michz/diy14bus/ideas.md

Brainstorming, Ideas
====================

pseudo ACK mechanism
--------------------
When packet is broadcasted to network, we can check if it was received by
waiting for receiving the same packet relayed by another node.
