michz/diy14bus/first-test-cowbus-one/README.md

first-test
==========

Simple LED blinking test for cowbus-one-board
