michz/diy14bus/spi-test-f0/README.md

first-test
==========

Simple LED blinking test for STM32F3Discovery
