michz/diy14bus/boards/cowbus-protoboard/pdf/schematics/cowbus-protoboard.pdf

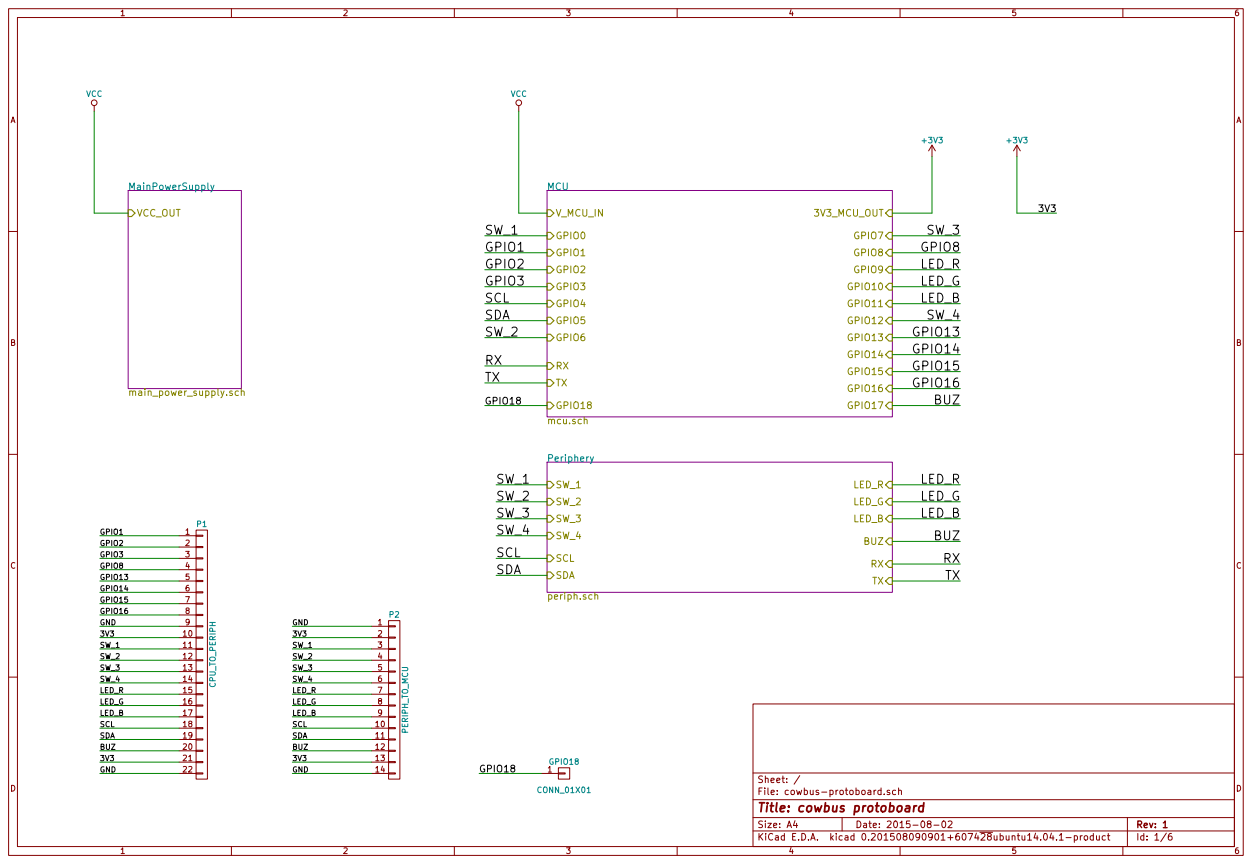
[picture p1: page 1]

File: cowbus-protoboard.sch Sheet: /
Id: 1/6 Title: cowbus protoboard

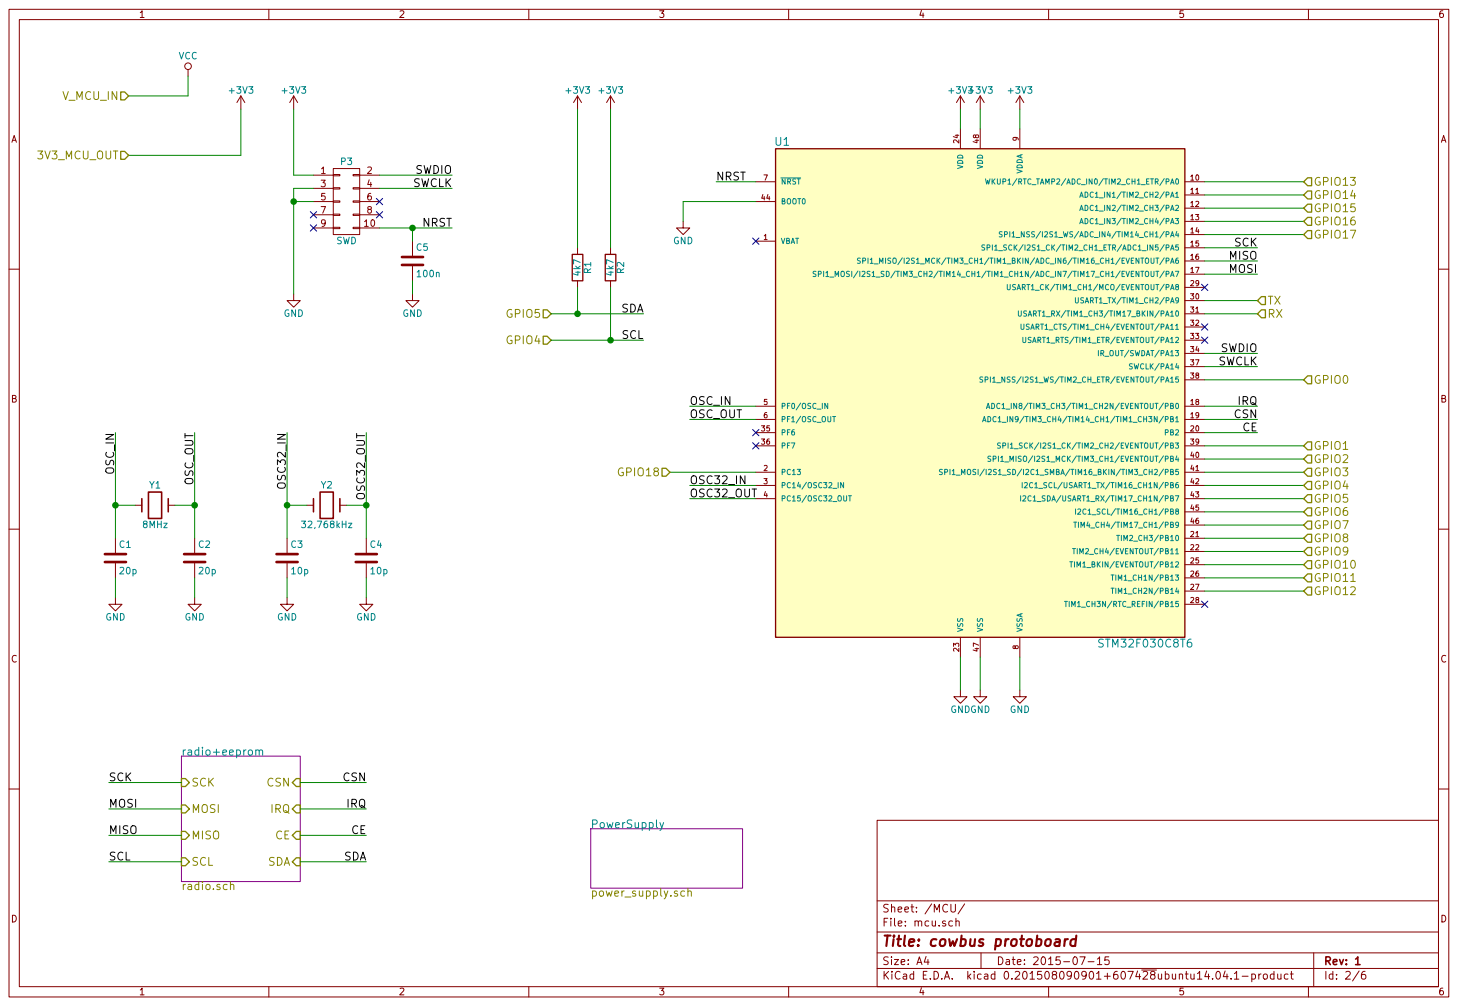
[picture p2: page 2]

File: mcu.sch Sheet: /MCU/
Id: 2/6 Title: cowbus protoboard

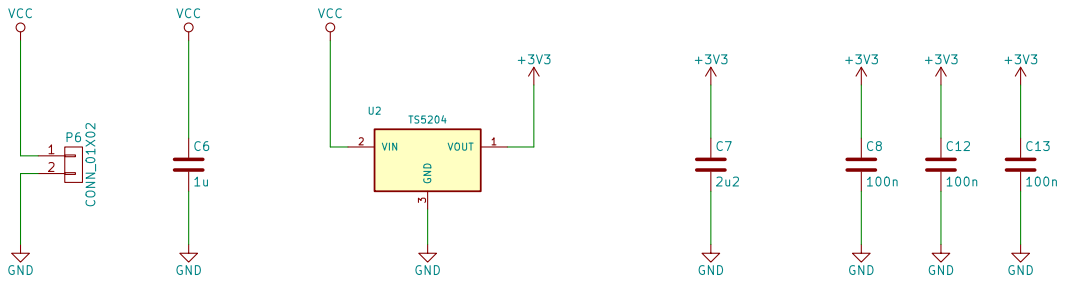
[picture p3: page 3]

File: power_supply.sch
Id: 3/6 Title: cowbus protoboard

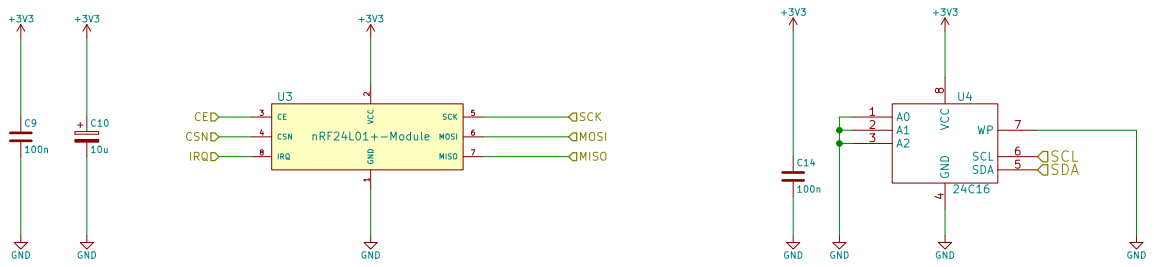
[picture p4: page 4]

2 CE 3 CSN 4 SCK 5 MOSI 6 MISO 7

File: radio.sch Sheet: /MCU/radio+eeprom/ GND

Id: 4/6 Title: cowbus protoboard

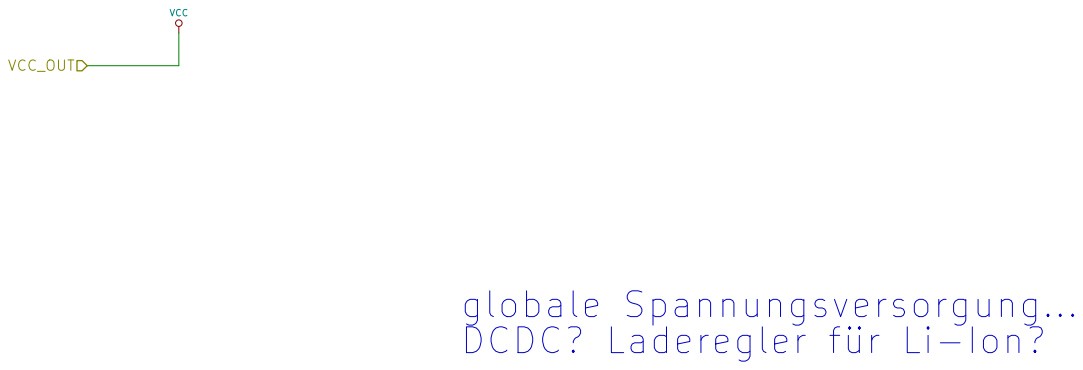
[picture p5: page 5]

globale Spannungsversorgung...
DCDC? Laderegler für Li-Ion?

Sheet: /MainPowerSupply/
File: main_power_supply.sch
Id: 5/6 Title: cowbus protoboard

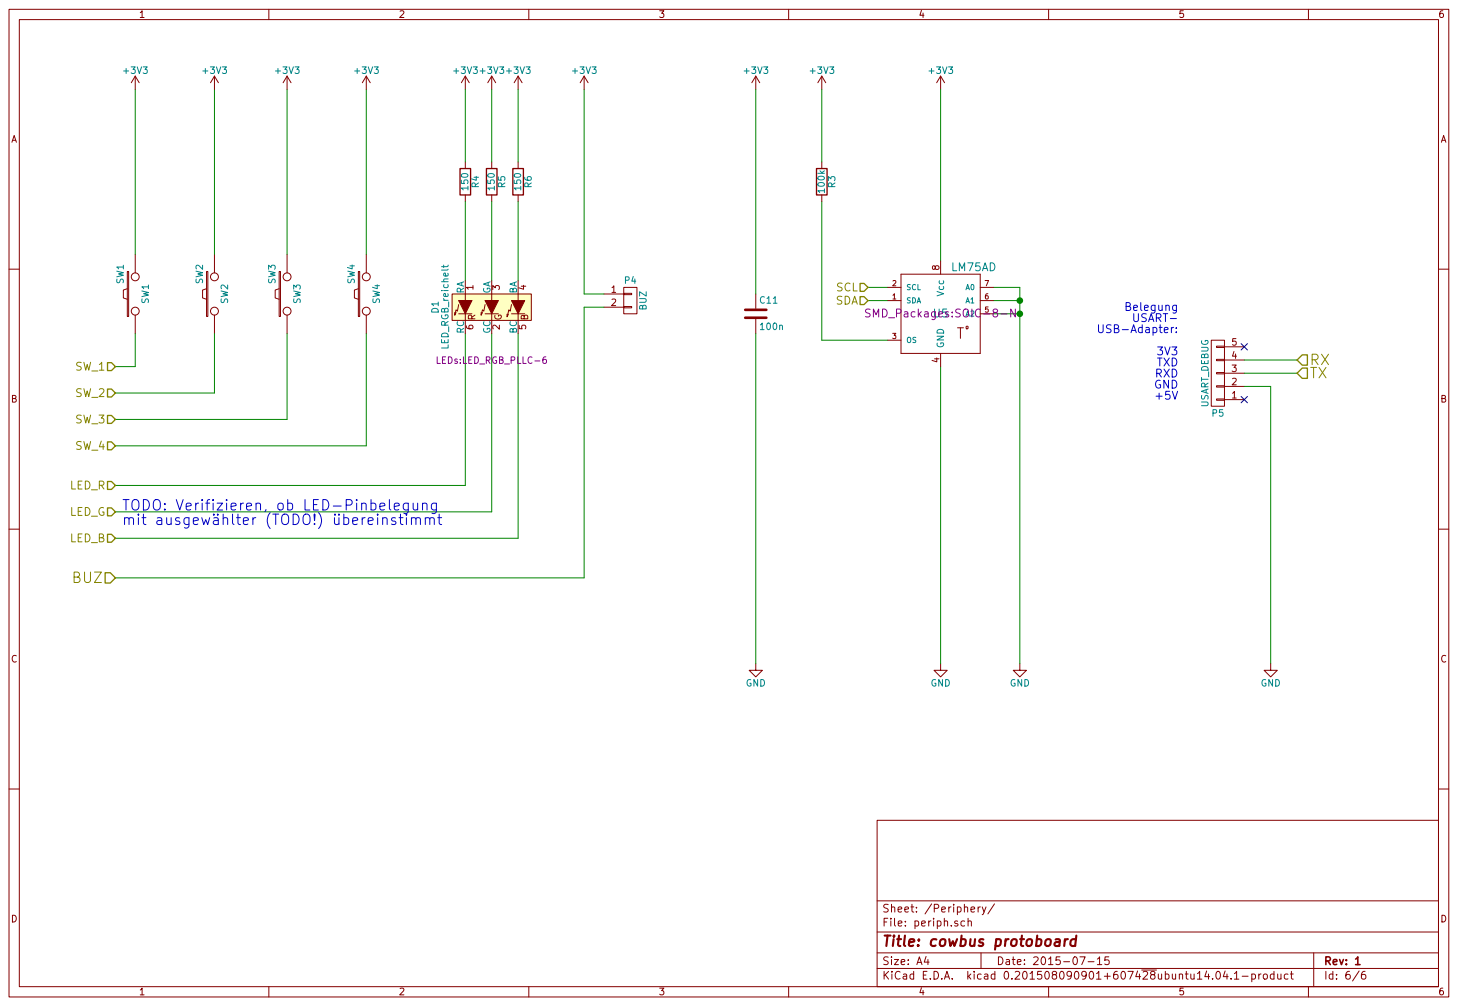
[picture p6: page 6]

TODO: Verifizieren, ob LED-Pinbelegung

File: periph.sch
Id: 6/6 Title: cowbus protoboard
