michz/diy14bus/boards/d14b_button/d14b_button.pdf

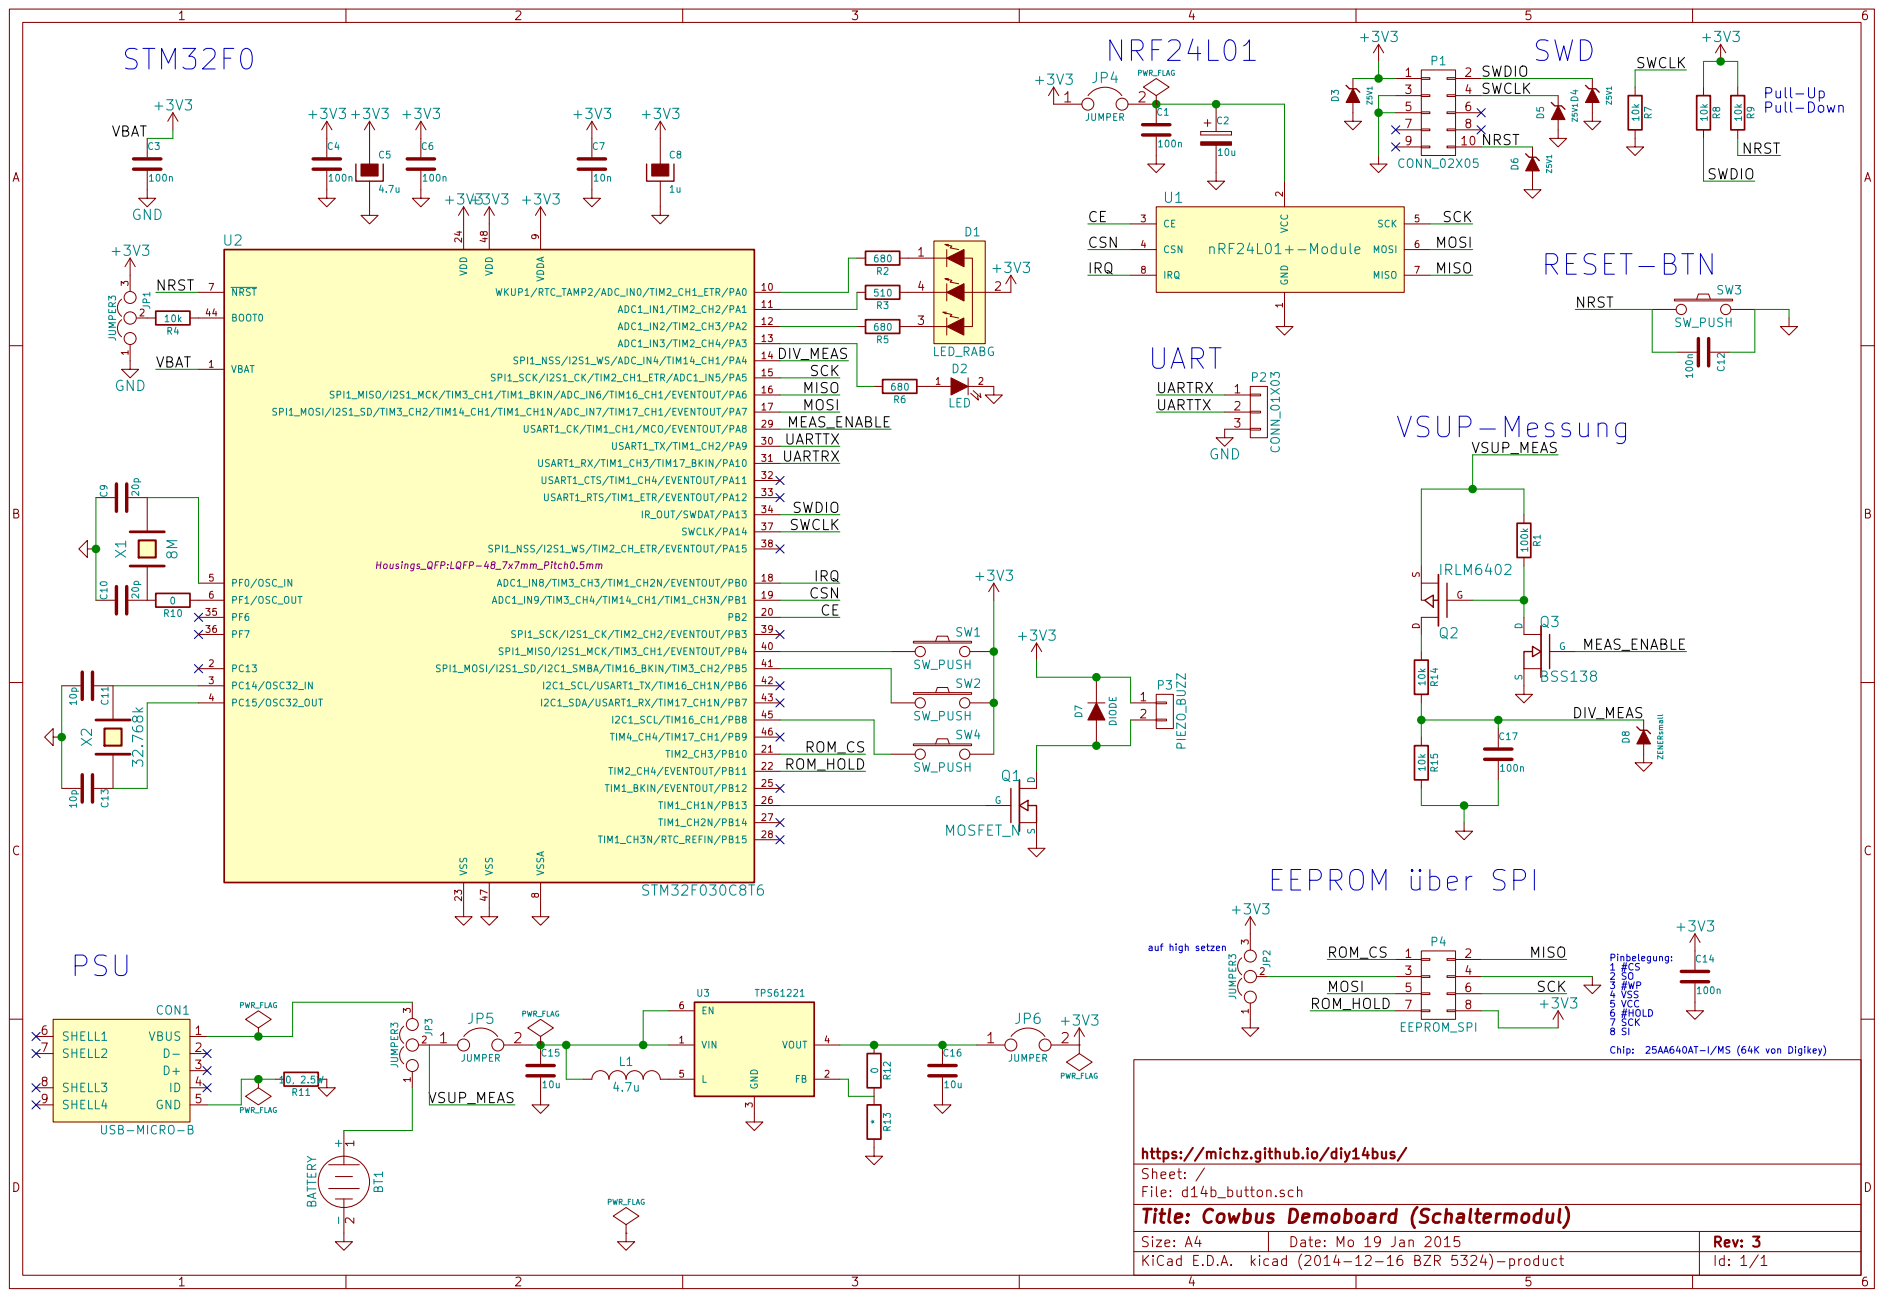
[picture p7: page 1]

File: d14b_button.sch Sheet: / https://michz.github.io/diy14bus/ GND

2 CE 3 CSN 4 SCK 5 MOSI 6 MISO 7

8 SI Chip: 25AA640AT-I/MS (64K von Digikey) 1

Id: 1/1 Title: Cowbus Demoboard (Schaltermodul)
