michz/diy14bus/boards/cowbus-protoboard/pdf/layout/cowbus-protoboard-F_SilkS.pdf

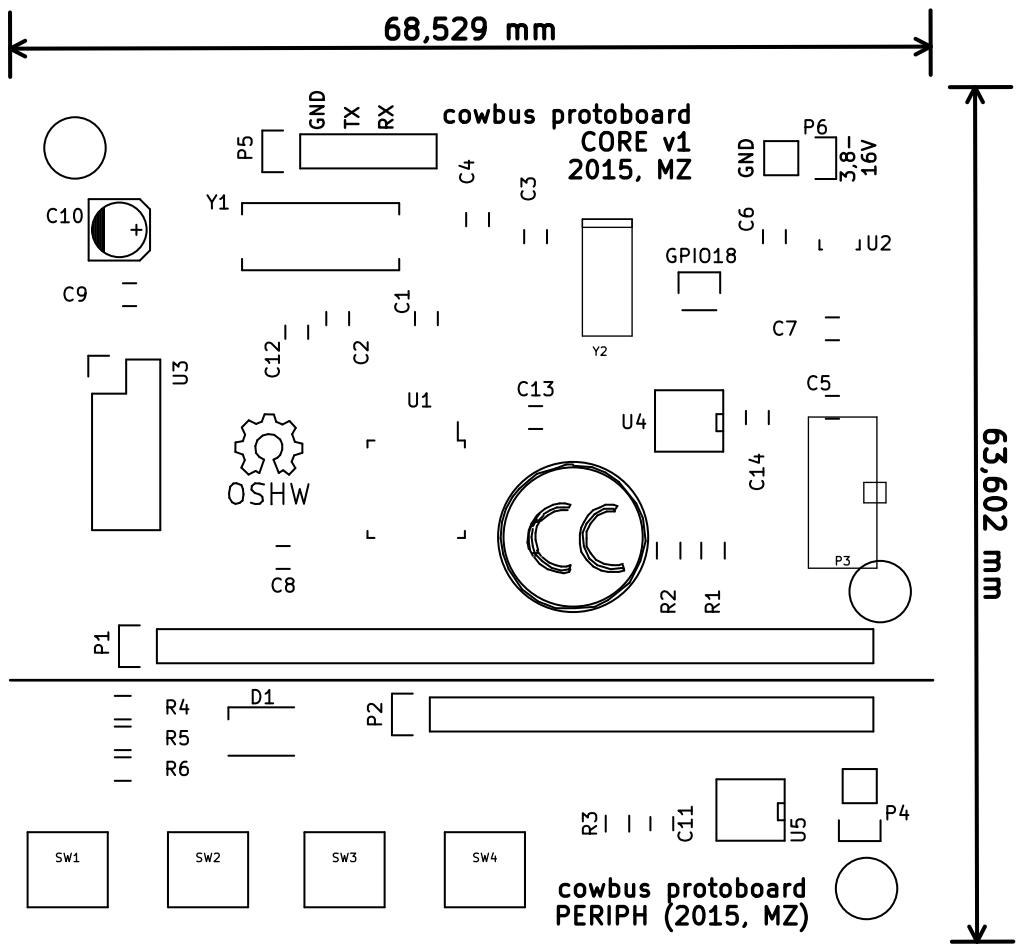
[picture p8: page 1]

GND 3,8- 16V GND TXRX 63,602 mm
