michz/diy14bus/boards/d14b_button/d14b_button-B_Cu.pdf

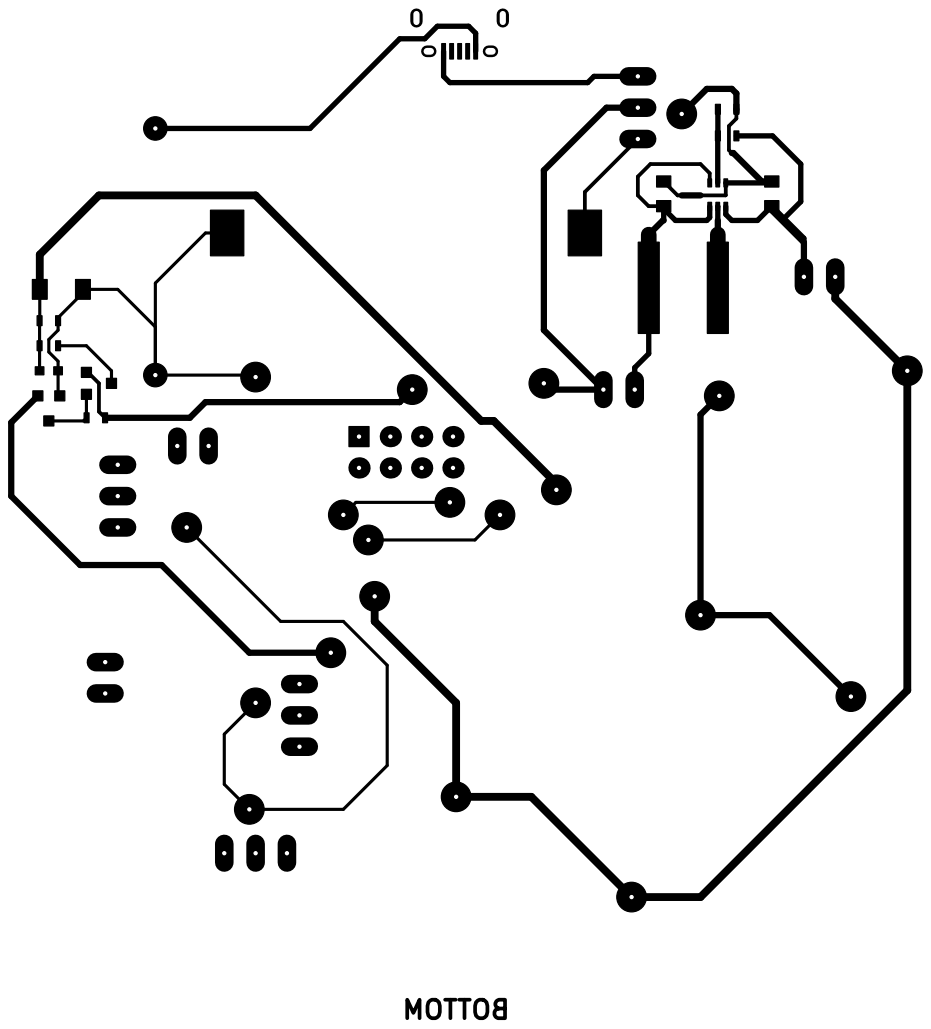
[picture p9: page 1]
