michz/diy14bus/boards/d14b_button/d14b_button-F_Cu.pdf

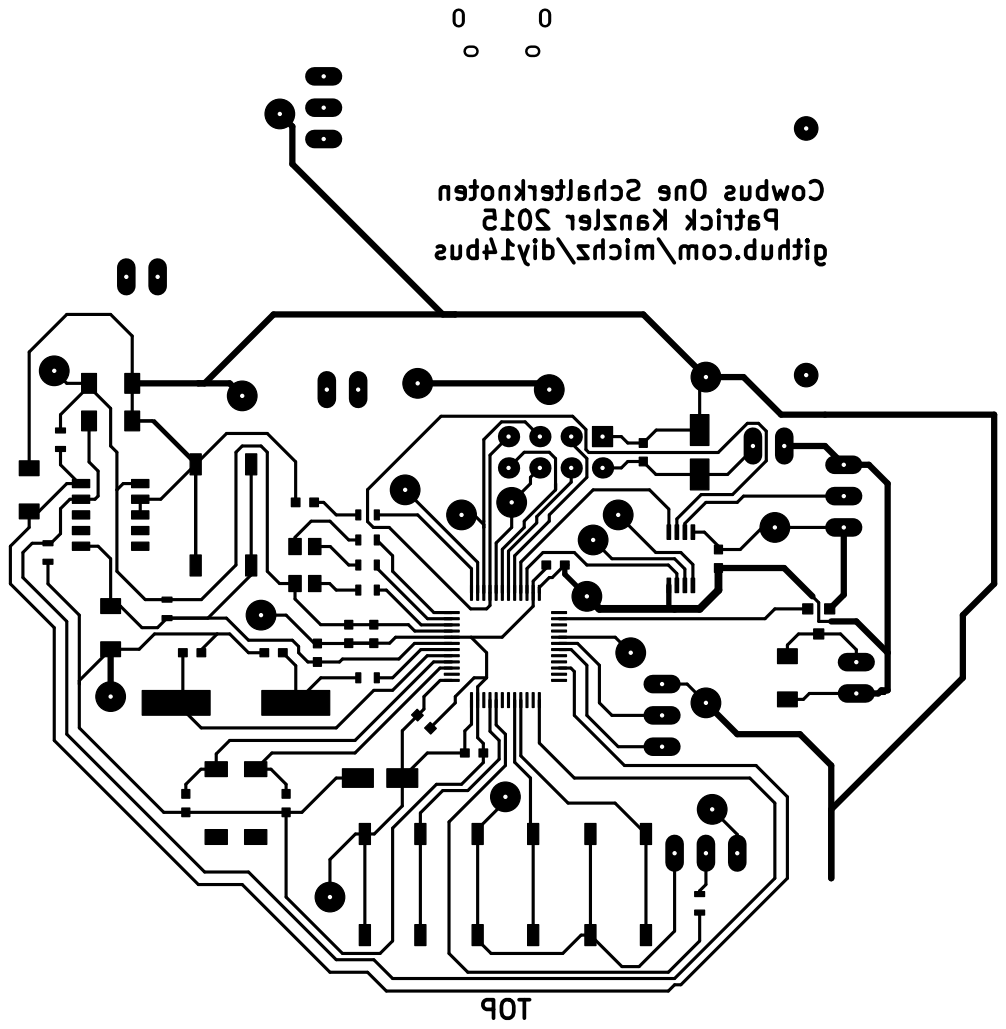
[picture p10: page 1]

Cowbus One Schalterknoten Patrick Kanzler 2015 github.com/michz/diy14bus TOP
