michz/diy14bus/doc/projekt_doku/img/system.pdf

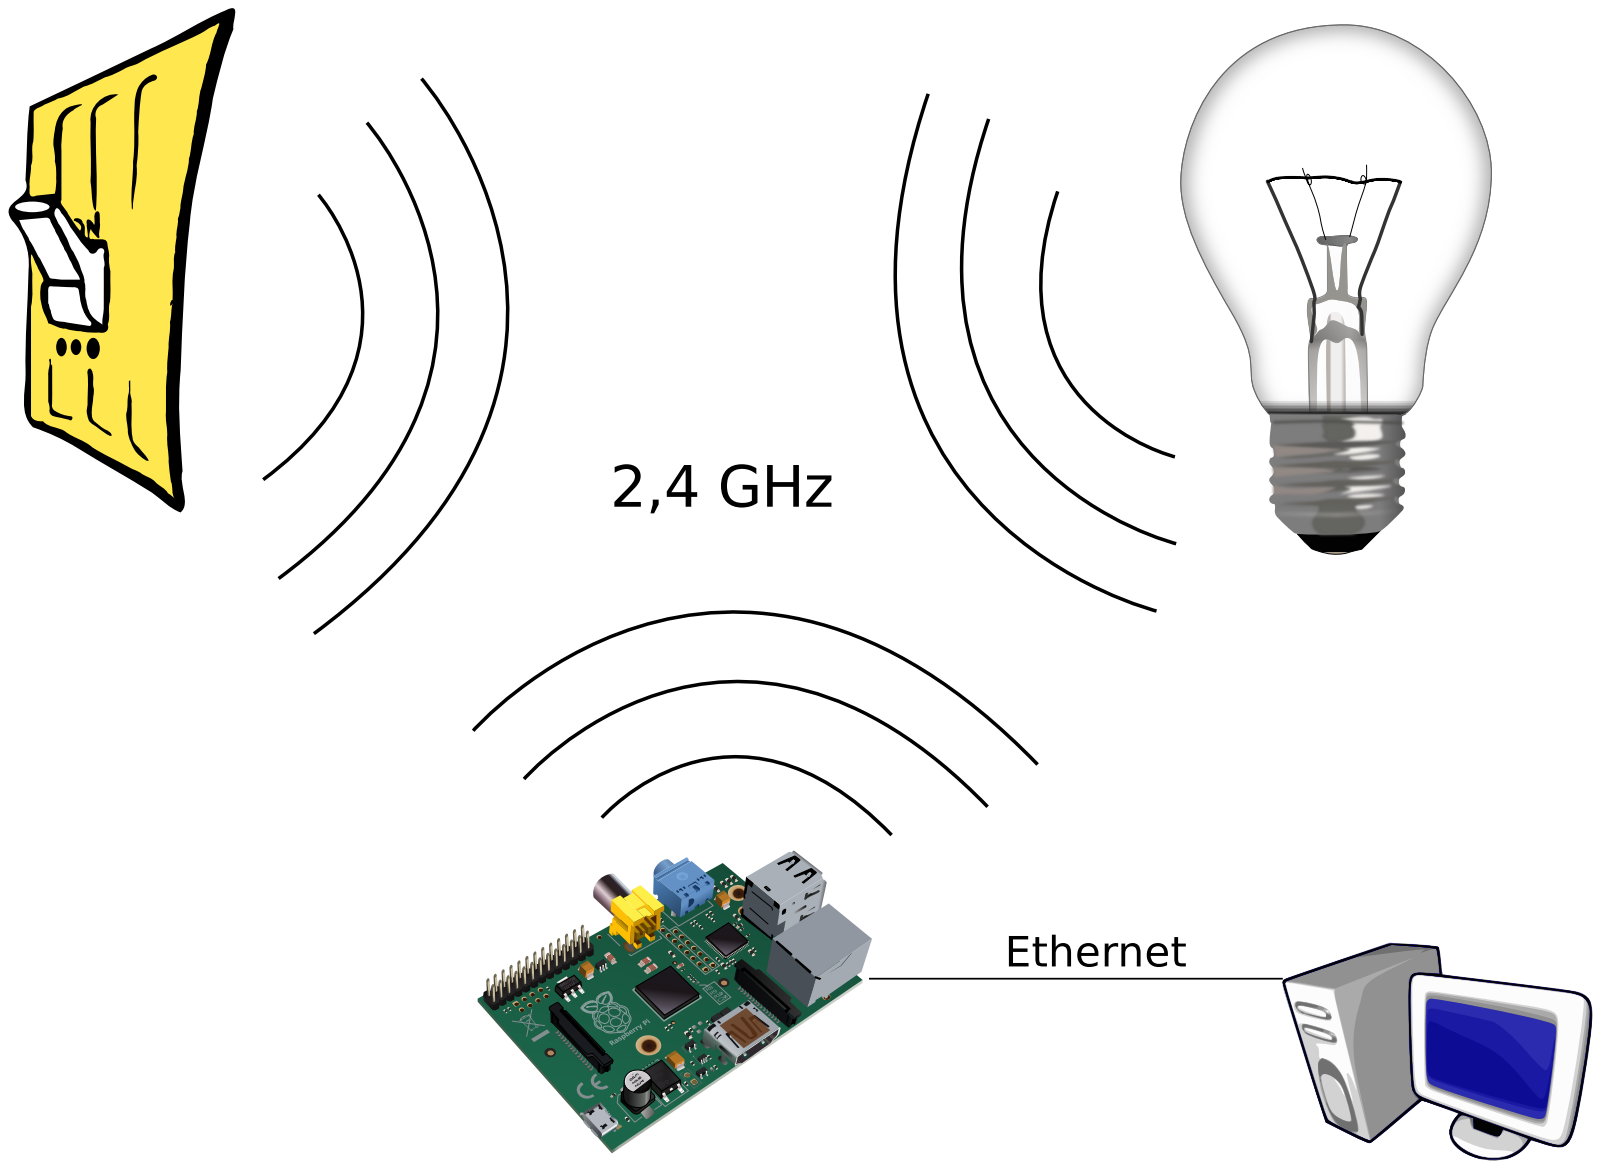
[picture p11: page 1]
