michz/diy14bus/boards/cowbus-protoboard/pdf/layout/cowbus-protoboard-B_Cu.pdf

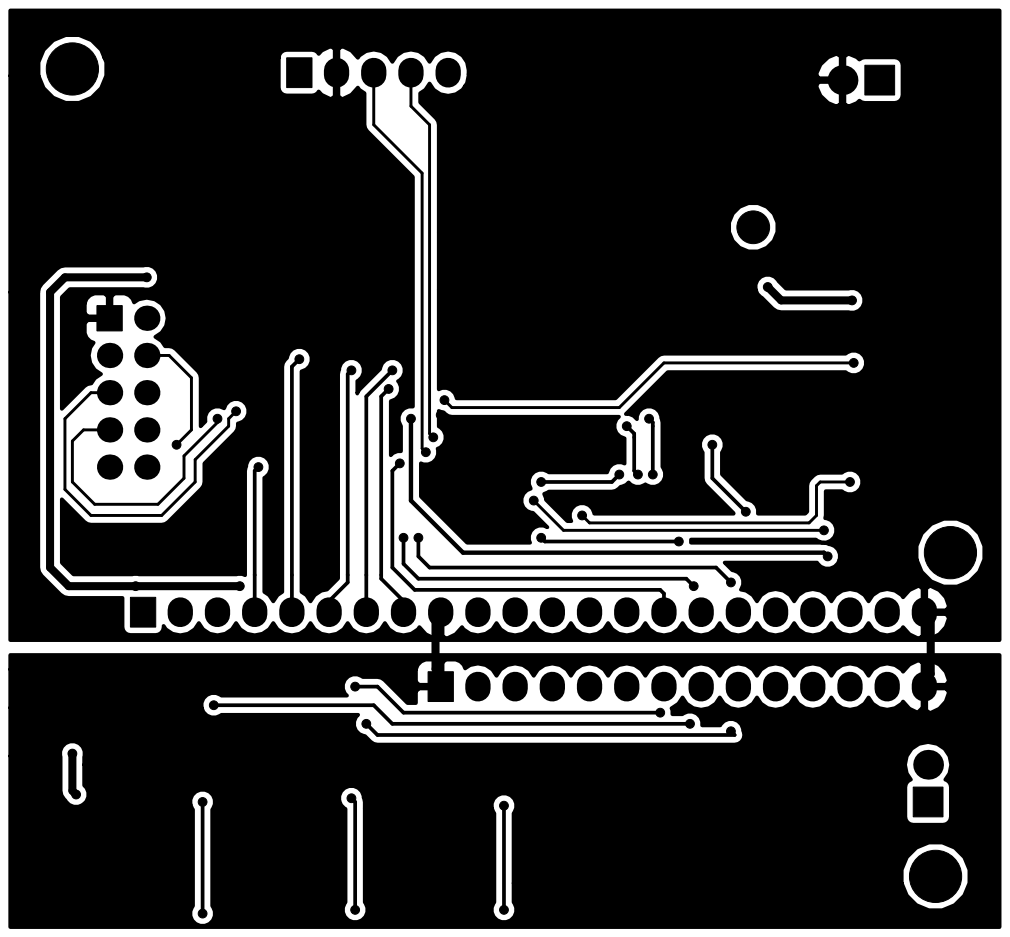
[picture p12: page 1]
