michz/diy14bus/boards/cowbus-protoboard/pdf/layout/cowbus-protoboard-B_Mask.pdf

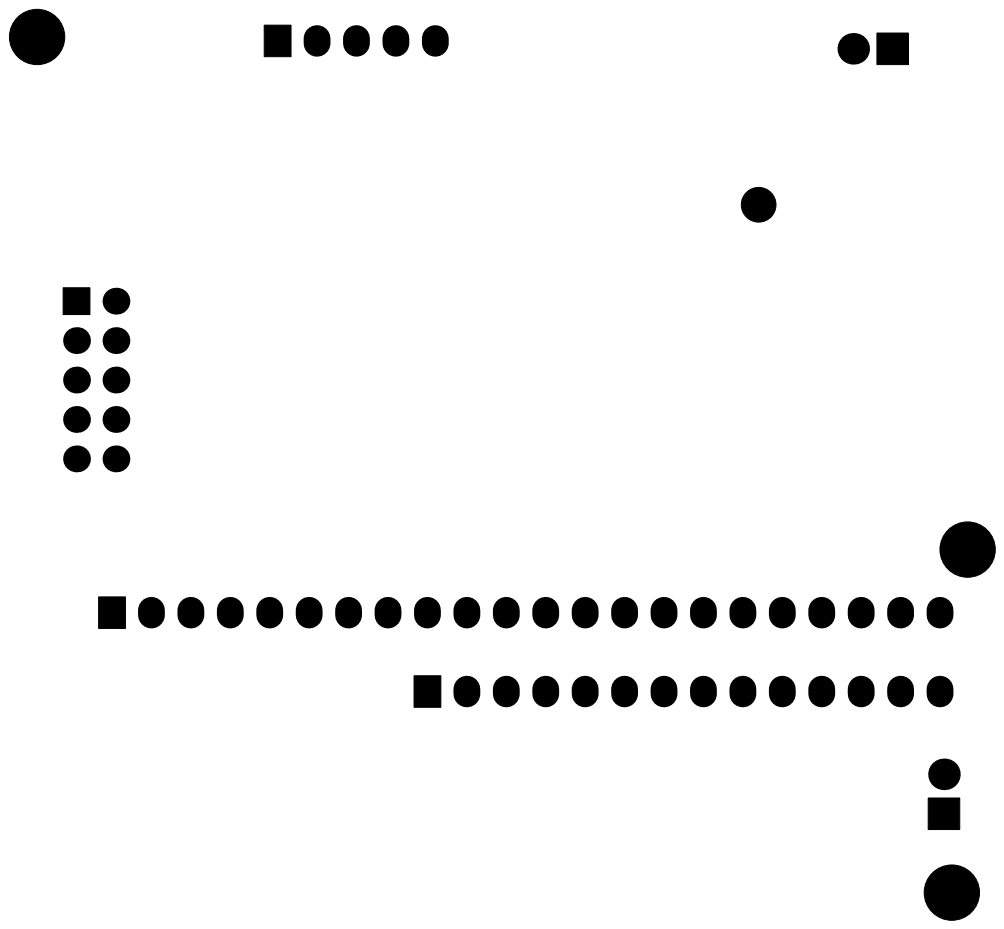
[picture p13: page 1]
