michz/diy14bus/boards/cowbus-protoboard/pdf/layout/cowbus-protoboard-F_Cu.pdf

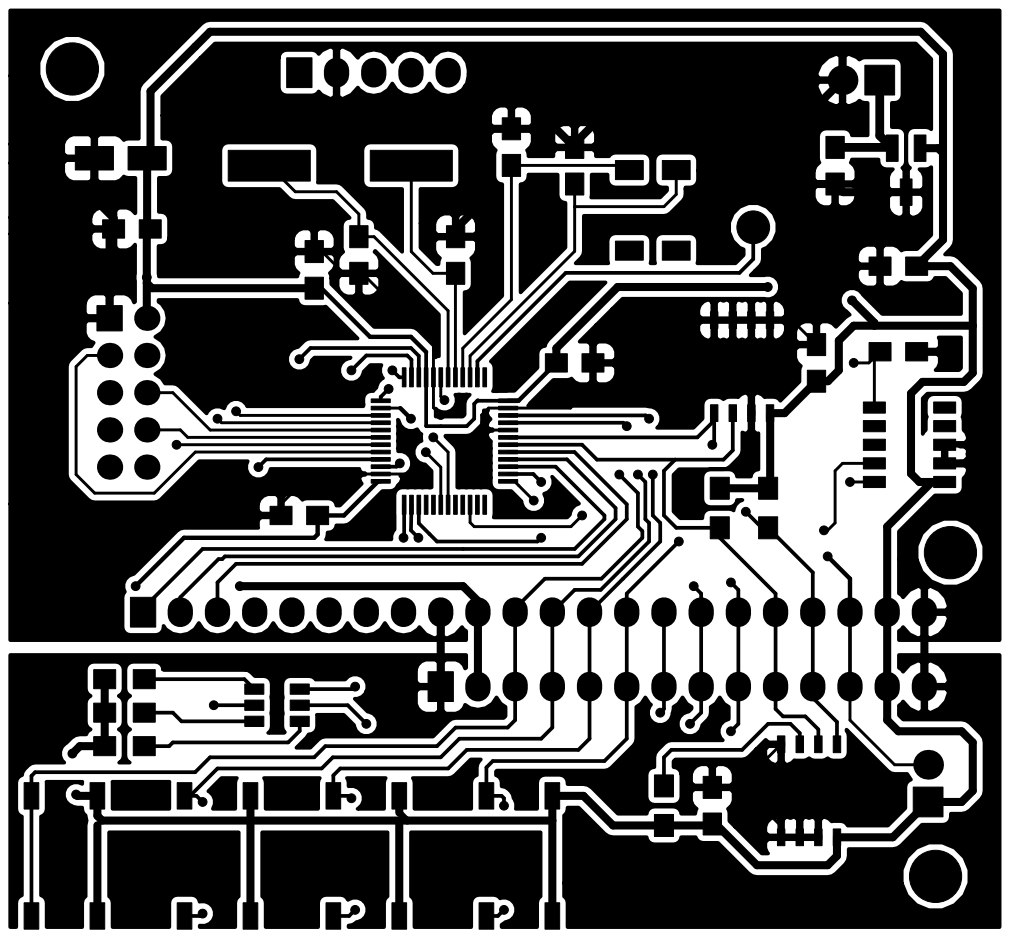
[picture p14: page 1]
