michz/diy14bus/boards/cowbus-protoboard/pdf/layout/cowbus-protoboard-F_Mask.pdf

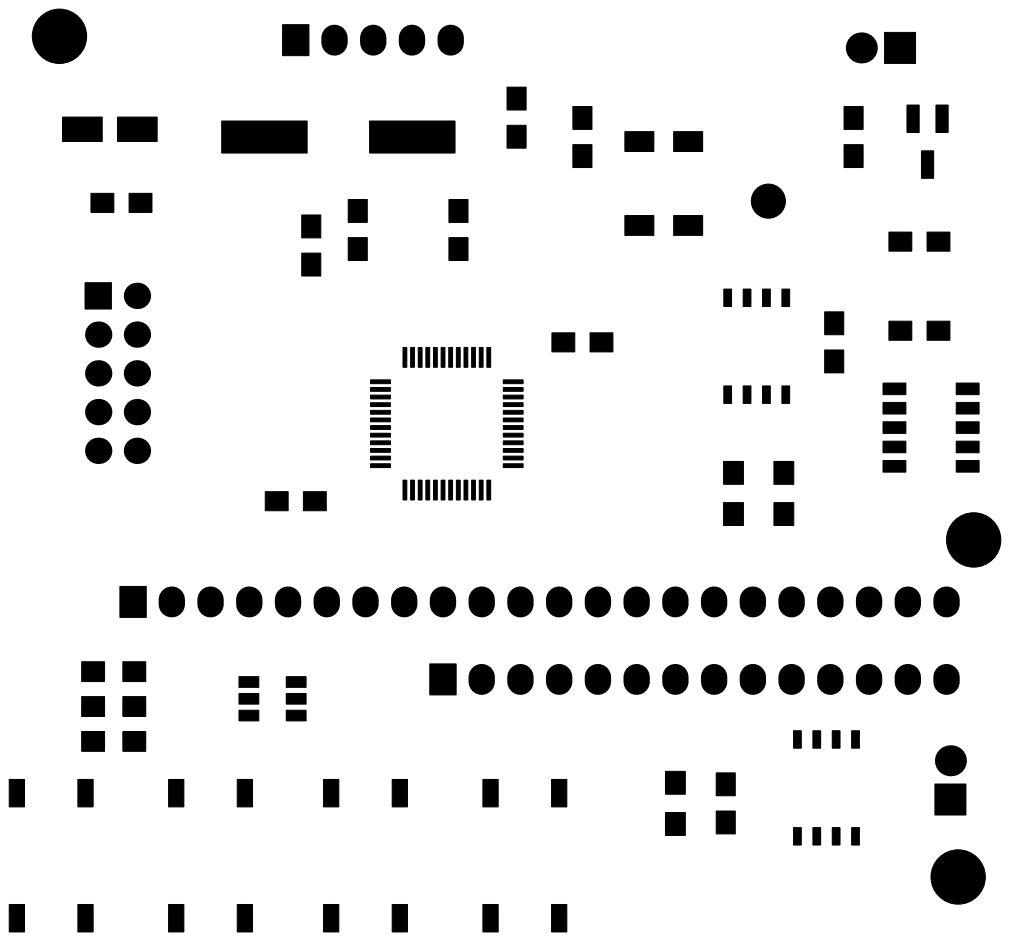
[picture p15: page 1]
