michz/diy14bus/boards/cowbus-protoboard/pdf/layout/cowbus-protoboard-F_Paste.pdf

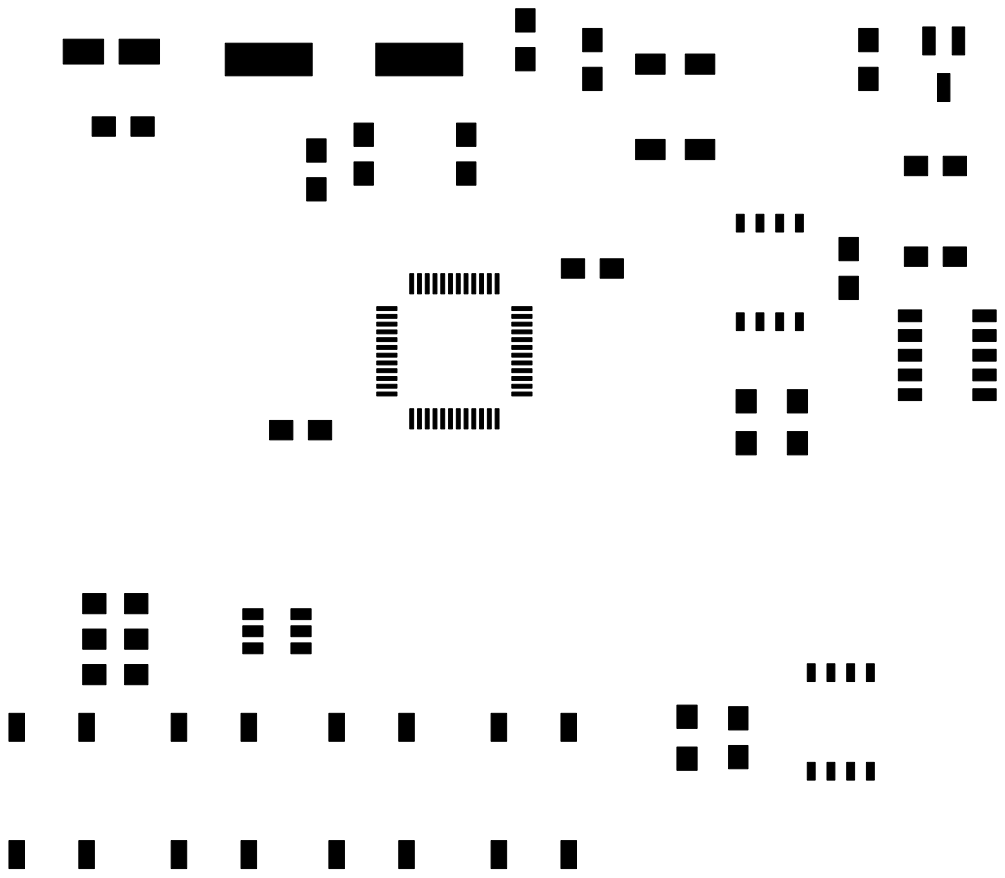
[picture p16: page 1]
