michz/diy14bus/boards/cowbus-protoboard/cowbus-protoboard.kicad_pcb

## KiCad design boards/cowbus-protoboard/cowbus-protoboard.kicad_pcb (2015-08-15)

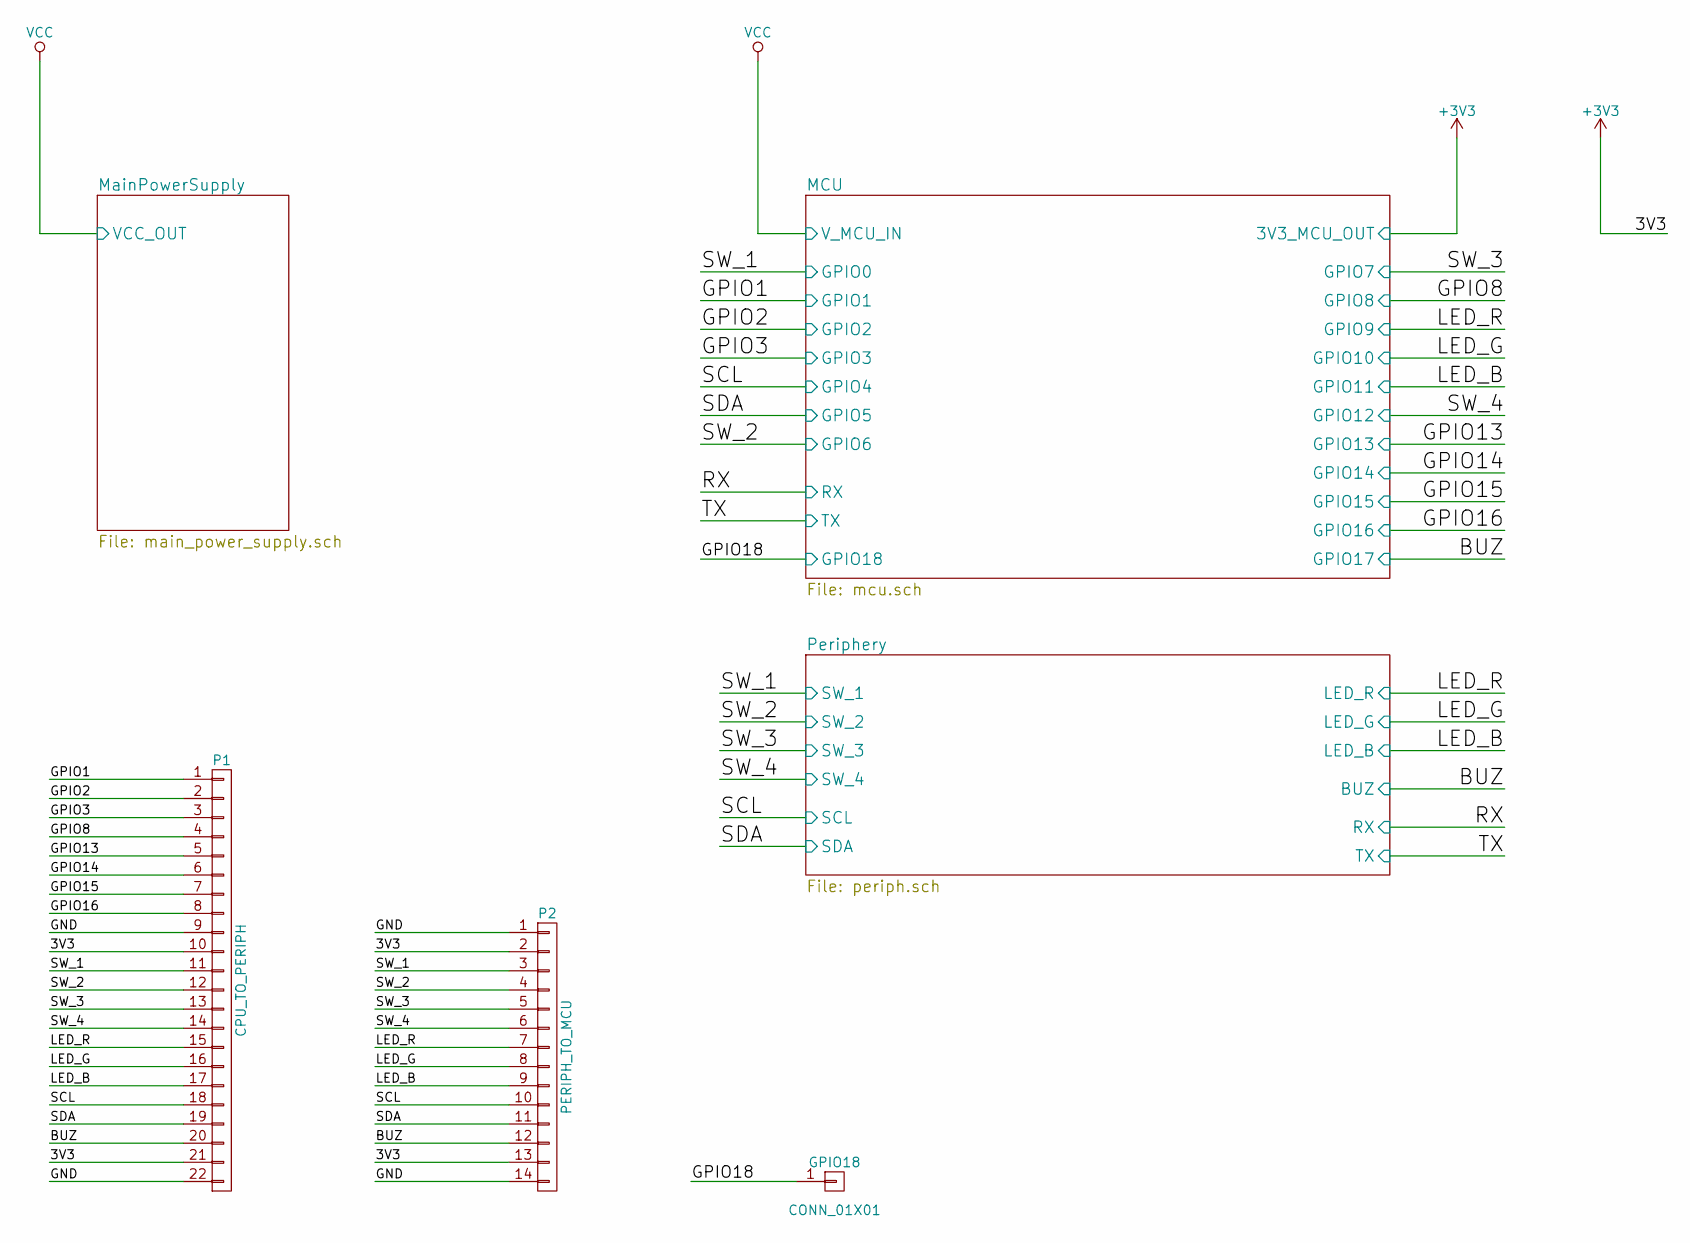
[picture p17: schematic cowbus-protoboard.sch, cowbus protoboard]

Parts:
GPIO18: CONN_01X01; Pin_Header_Straight_1x01
P1: CPU_TO_PERIPH; Pin_Header_Straight_1x22
P2: PERIPH_TO_MCU; Pin_Header_Straight_1x14

Connections:
+3V3: P1.10, P1.21, P2.2, P2.13; also elsewhere on the board
/MCU/GPIO0: P1.11, P2.3; also elsewhere on the board
/MCU/GPIO1: P1.1; also elsewhere on the board
/MCU/GPIO2: P1.2; also elsewhere on the board
/MCU/GPIO3: P1.3; also elsewhere on the board
/MCU/GPIO4: P1.18, P2.10; also elsewhere on the board
/MCU/GPIO5: P1.19, P2.11; also elsewhere on the board
/MCU/GPIO6: P1.12, P2.4; also elsewhere on the board
/MCU/GPIO7: P1.13, P2.5; also elsewhere on the board
/MCU/GPIO8: P1.4; also elsewhere on the board
/MCU/GPIO9: P1.15, P2.7; also elsewhere on the board
/MCU/GPIO10: P1.16, P2.8; also elsewhere on the board
/MCU/GPIO11: P1.17, P2.9; also elsewhere on the board
/MCU/GPIO12: P1.14, P2.6; also elsewhere on the board
/MCU/GPIO13: P1.5; also elsewhere on the board
/MCU/GPIO14: P1.6; also elsewhere on the board
/MCU/GPIO15: P1.7; also elsewhere on the board
/MCU/GPIO16: P1.8; also elsewhere on the board
/MCU/GPIO18: GPIO18.1; also elsewhere on the board
/Periphery/BUZ: P1.20, P2.12; also elsewhere on the board
GND: P1.9, P1.22, P2.1, P2.14; also elsewhere on the board

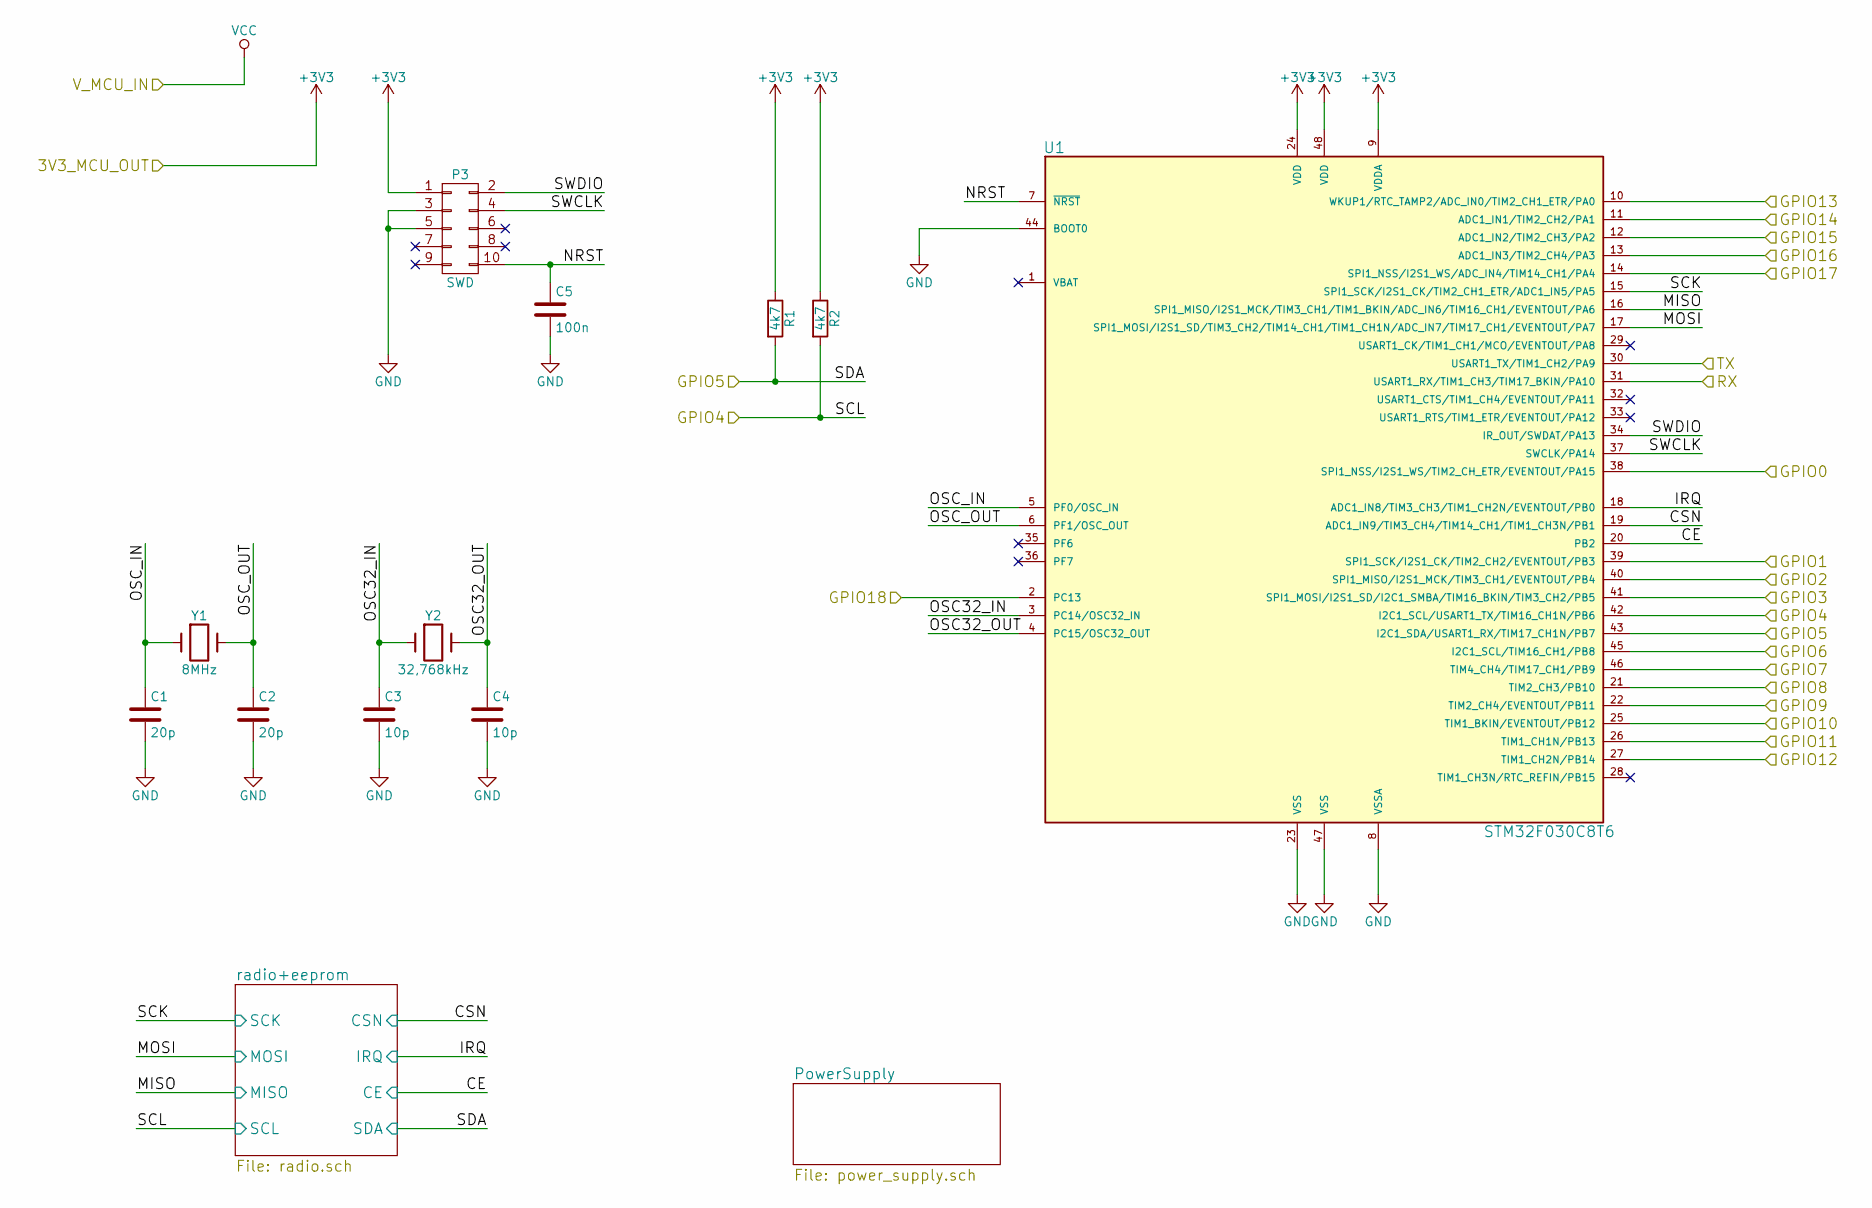
[picture p18: schematic mcu.sch, cowbus protoboard]

Parts:
C1, C2: 20p; C_0805_HandSoldering
C3, C4: 10p; C_0805_HandSoldering
C5: 100n; C_0805_HandSoldering
P3: SWD; CORTEX_header_SMD
R1, R2: 4k7; R_0805_HandSoldering
U1: STM32F030C8T6; LQFP-48_7x7mm_Pitch0.5mm
Y1: 8MHz; Crystal_HC49-SD_SMD
Y2: 32,768kHz; crystal_SMD_CPFB

Connections:
+3V3: P3.1, R1.1, R2.1, U1.9 (VDDA), U1.24 (VDD), U1.48 (VDD); also elsewhere on the board
/MCU/GPIO0: U1.38 (SPI1_NSS/I2S1_WS/TIM2_CH_ETR/EVENTOUT/P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); also elsewhere on the board
/MCU/GPIO1: U1.39 (SPI1_SCK/I2S1_CK/TIM2_CH2/EVENTOUT/PB3); also elsewhere on the board
/MCU/GPIO2: U1.40 (SPI1_MISO/I2S1_MCK/TIM3_CH1/EVENTOUT/PB4); also elsewhere on the board
/MCU/GPIO3: U1.41 (SPI1_MOSI/I2S1_SD/I2C1_SMBA/TIM16_BKIN/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); also elsewhere on the board
/MCU/GPIO4: R2.2, U1.42 (I2C1_SCL/USART1_TX/TIM16_CH1N/PB6); also elsewhere on the board
/MCU/GPIO5: R1.2, U1.43 (I2C1_SDA/USART1_RX/TIM17_CH1N/PB7); also elsewhere on the board
/MCU/GPIO6: U1.45 (I2C1_SCL/TIM16_CH1/PB8); also elsewhere on the board
/MCU/GPIO7: U1.46 (TIM4_CH4/TIM17_CH1/PB9); also elsewhere on the board
/MCU/GPIO8: U1.21 (TIM2_CH3/PB10); also elsewhere on the board
/MCU/GPIO9: U1.22 (TIM2_CH4/EVENTOUT/PB11); also elsewhere on the board
/MCU/GPIO10: U1.25 (TIM1_BKIN/EVENTOUT/PB12); also elsewhere on the board
/MCU/GPIO11: U1.26 (TIM1_CH1N/PB13); also elsewhere on the board
/MCU/GPIO12: U1.27 (TIM1_CH2N/PB14); also elsewhere on the board
/MCU/GPIO13: U1.10 (WKUP1/RTC_TAMP2/ADC_IN0/TIM2_CH1_ETR/PA0); also elsewhere on the board
/MCU/GPIO14: U1.11 (ADC1_IN1/TIM2_CH2/PA1); also elsewhere on the board
/MCU/GPIO15: U1.12 (ADC1_IN2/TIM2_CH3/PA2); also elsewhere on the board
/MCU/GPIO16: U1.13 (ADC1_IN3/TIM2_CH4/PA3); also elsewhere on the board
/MCU/GPIO18: U1.2 (PC13); also elsewhere on the board
/MCU/NRST: C5.1, P3.10, U1.7 (~NRST)
/MCU/OSC32_IN: C3.1, U1.3 (PC14/OSC32_IN), Y2.1
/MCU/OSC32_OUT: C4.1, U1.4 (PC15/OSC32_OUT), Y2.2
/MCU/OSC_IN: C1.1, U1.5 (PF0/OSC_IN), Y1.1
/MCU/OSC_OUT: C2.1, U1.6 (PF1/OSC_OUT), Y1.2
/MCU/RX: U1.31 (USART1_RX/TIM1_CH3/TIM17_BKIN/PA10); also elsewhere on the board
/MCU/SWCLK: P3.4, U1.37 (SWCLK/PA14)
/MCU/SWDIO: P3.2, U1.34 (IR_OUT/SWDAT/PA13)
/MCU/TX: U1.30 (USART1_TX/TIM1_CH2/PA9); also elsewhere on the board
/MCU/radio+eeprom/CE: U1.20 (PB2); also elsewhere on the board
/MCU/radio+eeprom/CSN: U1.19 (ADC1_IN9/TIM3_CH4/TIM14_CH1/TIM1_CH3N/P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); also elsewhere on the board
/MCU/radio+eeprom/IRQ: U1.18 (ADC1_IN8/TIM3_CH3/TIM1_CH2N/EVENTOUT/PB0); also elsewhere on the board
/MCU/radio+eeprom/MISO: U1.16 (SPI1_MISO/I2S1_MCK/TIM3_CH1/TIM1_BKIN/A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); also elsewhere on the board
/MCU/radio+eeprom/MOSI: U1.17 (SPI1_MOSI/I2S1_SD/TIM3_CH2/TIM14_CH1/TI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); also elsewhere on the board
/MCU/radio+eeprom/SCK: U1.15 (SPI1_SCK/I2S1_CK/TIM2_CH1_ETR/ADC1_IN5/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); also elsewhere on the board
/Periphery/BUZ: U1.14 (SPI1_NSS/I2S1_WS/ADC_IN4/TIM14_CH1/PA4); also elsewhere on the board
GND: C1.2, C2.2, C3.2, C4.2, C5.2, P3.3, P3.5, U1.8 (VSSA), U1.23 (VSS), U1.44 (BOOT0), U1.47 (VSS); also elsewhere on the board

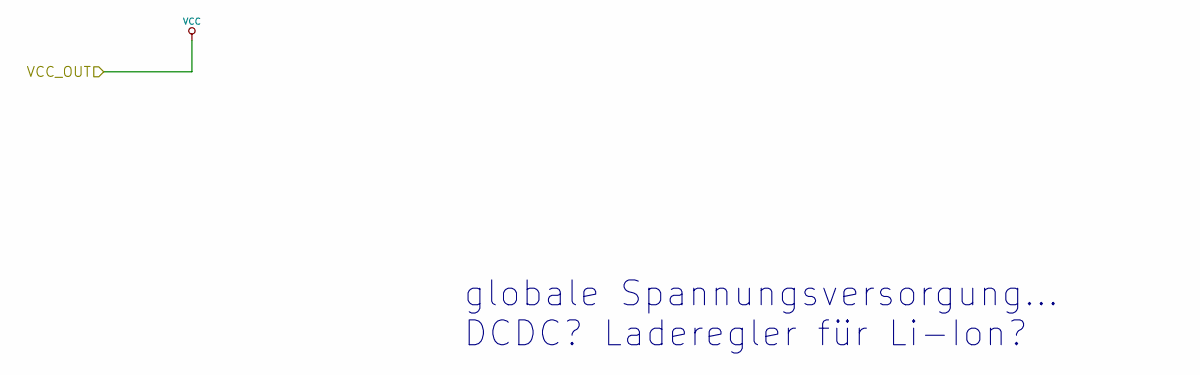
[picture p19: schematic main_power_supply.sch, cowbus protoboard]

Notes on the sheet:
globale Spannungsversorgung... DCDC? Laderegler für Li-Ion?

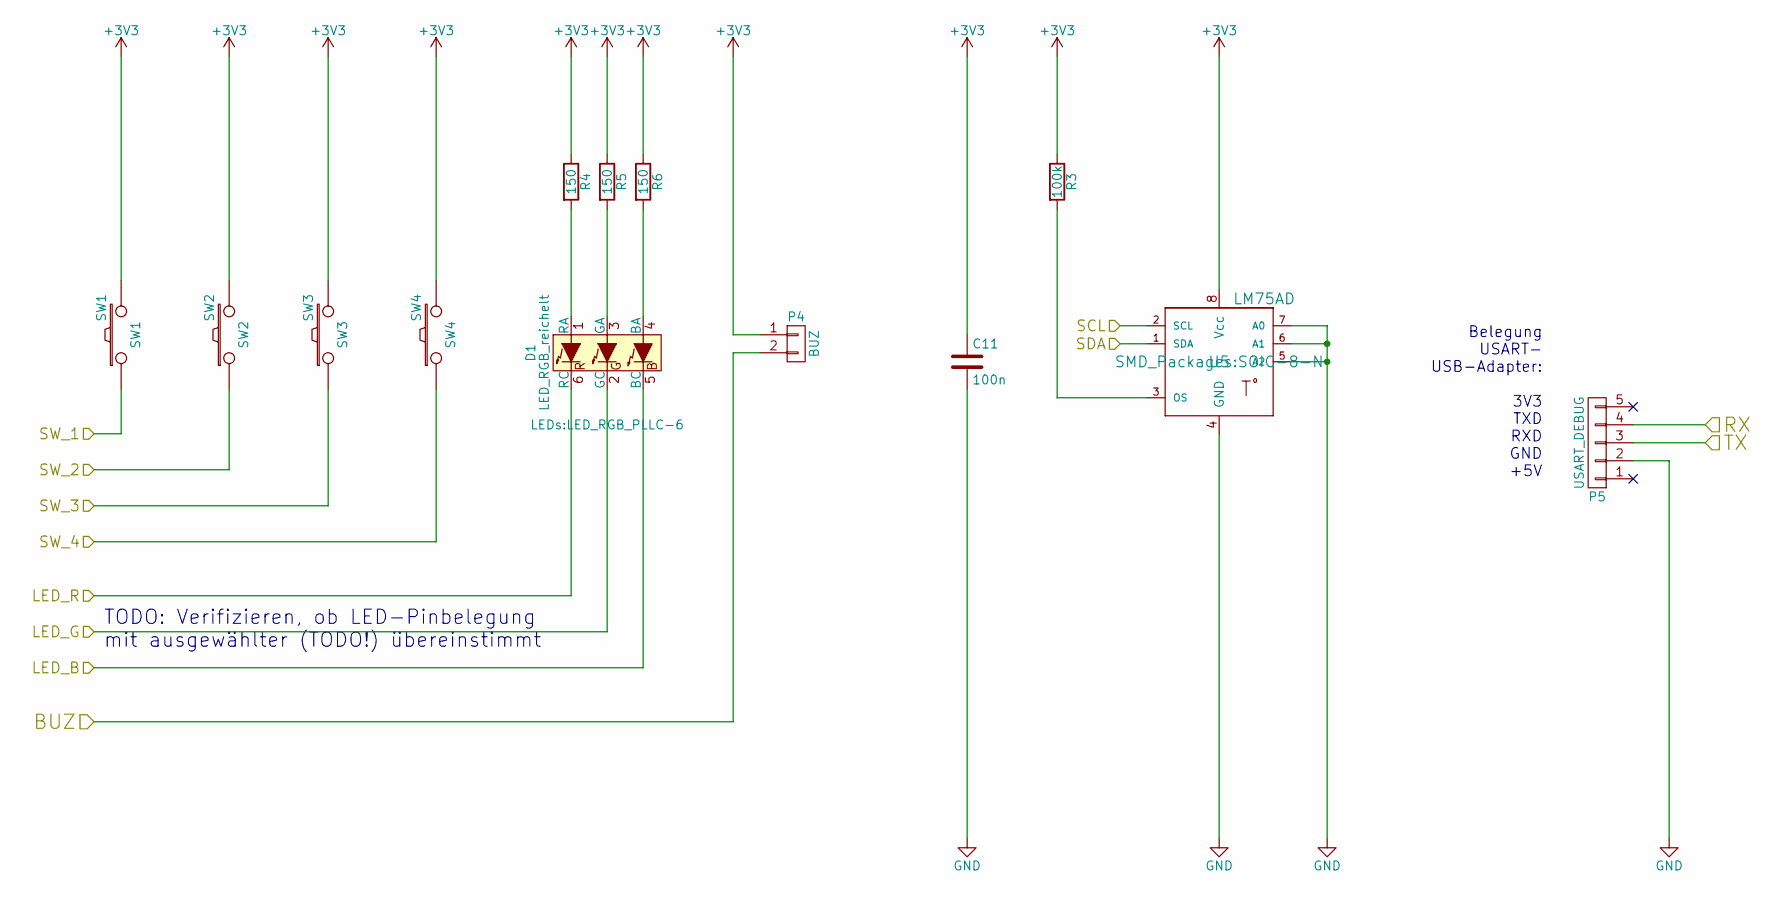
[picture p20: schematic periph.sch, cowbus protoboard]

Parts:
C11: 100n; C_0805_HandSoldering
D1: LED_RGB_reichelt; LED_RGB_PLLC-6
P4: BUZ; Pin_Header_Straight_1x02
P5: USART_DEBUG; Pin_Header_Straight_1x05
R3: 100k; R_0805_HandSoldering
R4, R5, R6: 150; R_0805_HandSoldering
SW1: SW1; Button_SMD_Schurter_LSG
SW2: SW2; Button_SMD_Schurter_LSG
SW3: SW3; Button_SMD_Schurter_LSG
SW4: SW4; Button_SMD_Schurter_LSG
U5: LM75AD; SOIC-8-N

Connections:
+3V3: C11.1, P4.1, R3.1, R4.1, R5.1, R6.1, SW1.2, SW2.2, SW3.2, SW4.2, U5.8 (Vcc); also elsewhere on the board
/MCU/GPIO0: SW1.1; also elsewhere on the board
/MCU/GPIO4: U5.2 (SCL); also elsewhere on the board
/MCU/GPIO5: U5.1 (SDA); also elsewhere on the board
/MCU/GPIO6: SW2.1; also elsewhere on the board
/MCU/GPIO7: SW3.1; also elsewhere on the board
/MCU/GPIO9: D1.6 (RC); also elsewhere on the board
/MCU/GPIO10: D1.2 (GC); also elsewhere on the board
/MCU/GPIO11: D1.5 (BC); also elsewhere on the board
/MCU/GPIO12: SW4.1; also elsewhere on the board
/MCU/RX: P5.4; also elsewhere on the board
/MCU/TX: P5.3; also elsewhere on the board
/Periphery/BUZ: P4.2; also elsewhere on the board
GND: C11.2, P5.2, U5.4 (GND), U5.5 (A2), U5.6 (A1), U5.7 (A0); also elsewhere on the board
unnamed: D1.1 (RA), R4.2
unnamed: D1.3 (GA), R5.2
unnamed: D1.4 (BA), R6.2
unnamed: R3.2, U5.3 (OS)

Notes on the sheet:
TODO: Verifizieren, ob LED-Pinbelegung mit ausgewählter (TODO!) übereinstimmt
Belegung USART- USB-Adapter: 3V3 TXD RXD GND +5V

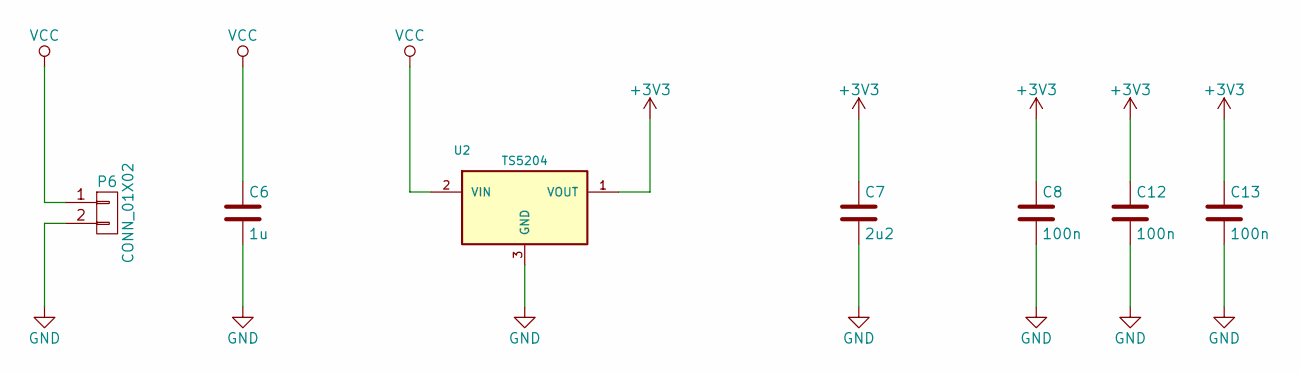
[picture p21: schematic power_supply.sch, cowbus protoboard]

Parts:
C6: 1u; C_0805_HandSoldering
C7: 2u2; C_0805_HandSoldering
C8, C12, C13: 100n; C_0805_HandSoldering
P6: CONN_01X02; Pin_Header_Straight_1x02
U2: TS5204; SOT-23_Handsoldering

Connections:
+3V3: C7.1, C8.1, C12.1, C13.1, U2.1 (VOUT); also elsewhere on the board
GND: C6.2, C7.2, C8.2, C12.2, C13.2, P6.2, U2.3 (GND); also elsewhere on the board
VCC: C6.1, P6.1, U2.2 (VIN)

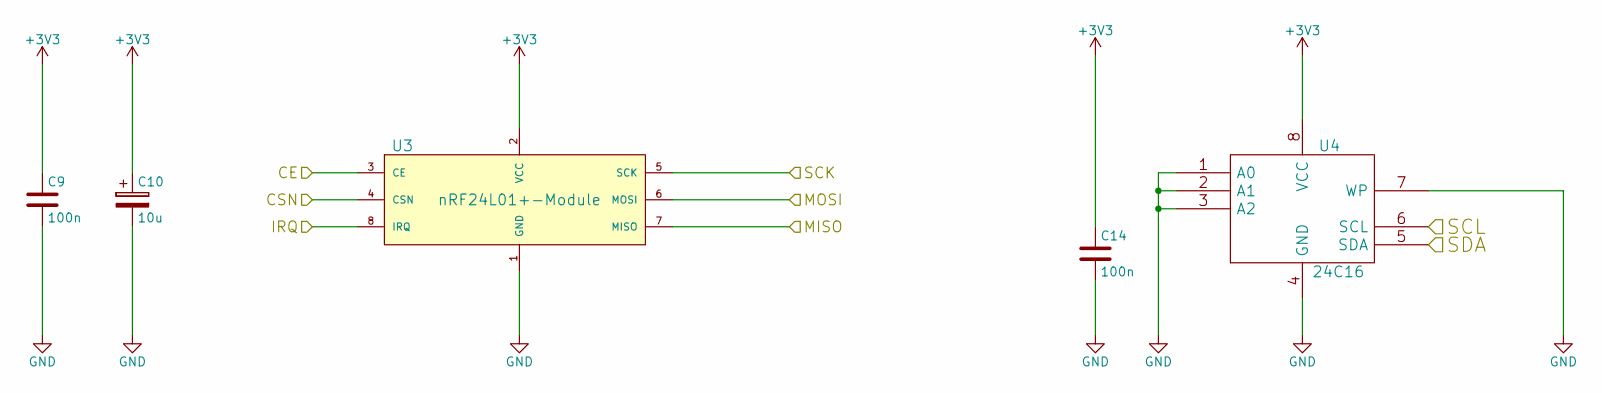
[picture p22: schematic radio.sch, cowbus protoboard]

Parts:
C9, C14: 100n; C_0805_HandSoldering
C10: 10u; c_elec_4x5.8
U3: nRF24L01+-Module; Pin_Header_Straight_2x05
U4: 24C16; SOIC-8-N

Connections:
+3V3: C9.1, C10.1, C14.1, U3.2 (VCC), U4.8 (VCC); also elsewhere on the board
/MCU/GPIO4: U4.6 (SCL); also elsewhere on the board
/MCU/GPIO5: U4.5 (SDA); also elsewhere on the board
/MCU/radio+eeprom/CE: U3.3 (CE); also elsewhere on the board
/MCU/radio+eeprom/CSN: U3.4 (CSN); also elsewhere on the board
/MCU/radio+eeprom/IRQ: U3.8 (IRQ); also elsewhere on the board
/MCU/radio+eeprom/MISO: U3.7 (MISO); also elsewhere on the board
/MCU/radio+eeprom/MOSI: U3.6 (MOSI); also elsewhere on the board
/MCU/radio+eeprom/SCK: U3.5 (SCK); also elsewhere on the board
GND: C9.2, C10.2, C14.2, U3.1 (GND), U4.1 (A0), U4.2 (A1), U4.3 (A2), U4.4 (GND), U4.7 (WP); also elsewhere on the board

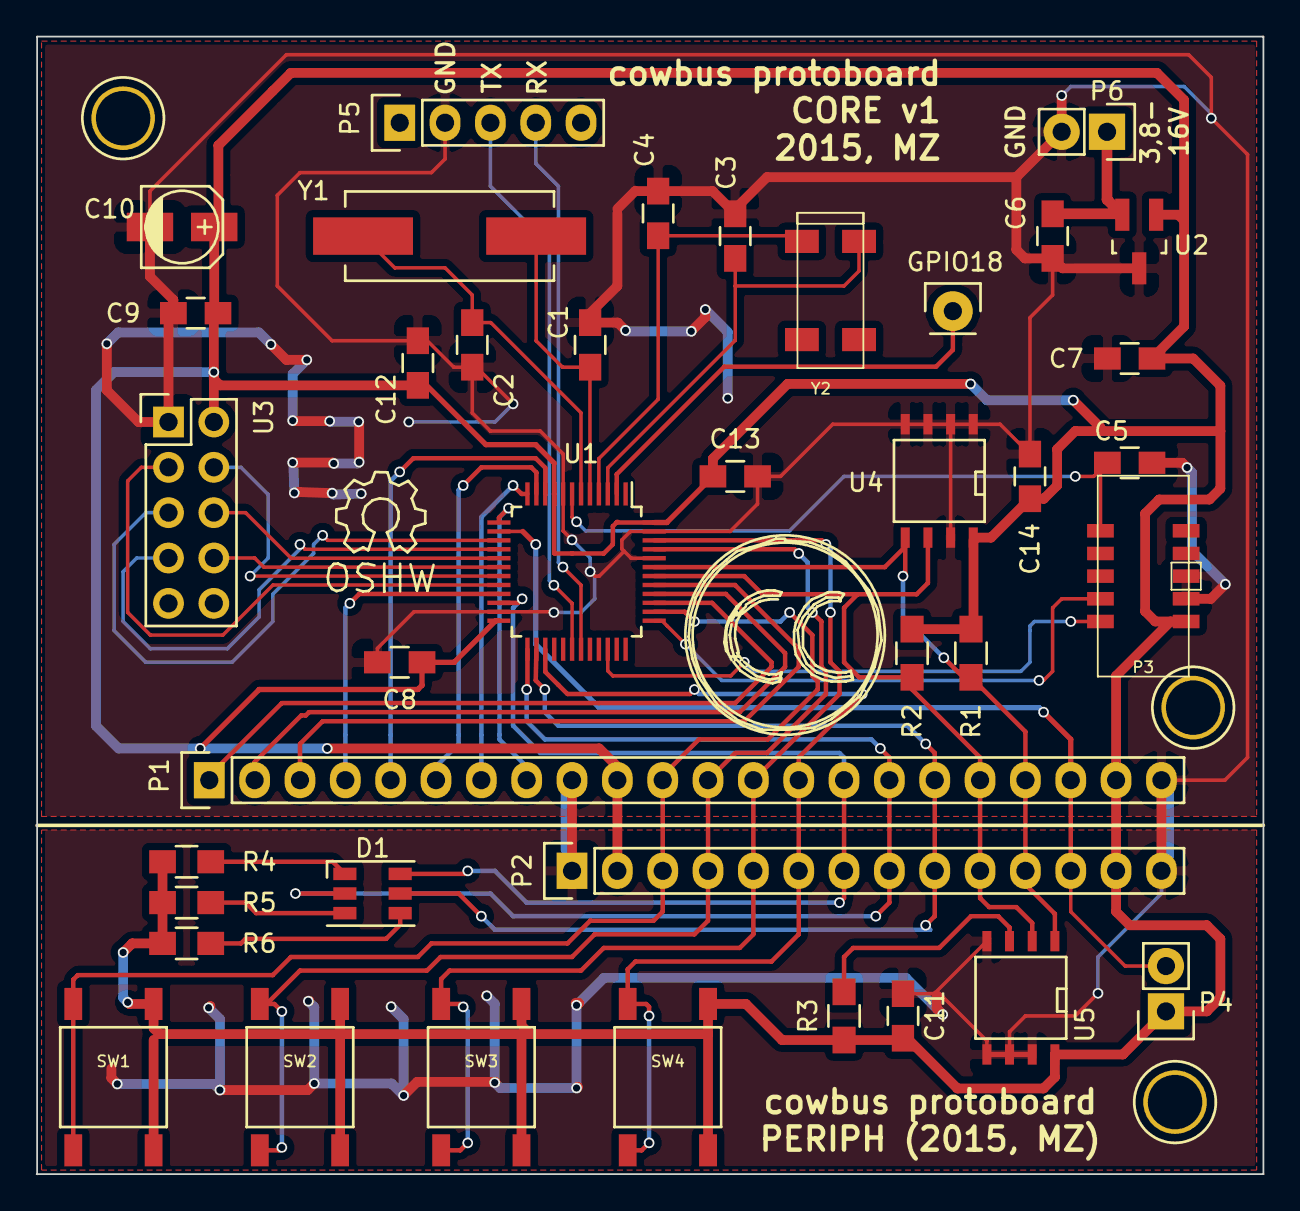
[picture p23: board cowbus-protoboard.kicad_pcb from above]

Board: 2 copper layers, 68.7 x 63.7 mm, 39 parts (0 on the bottom side), 41 nets.
