michz/diy14bus/boards/d14b_button/d14b_button.kicad_pcb

## KiCad design boards/d14b_button/d14b_button.kicad_pcb (2015-05-15)

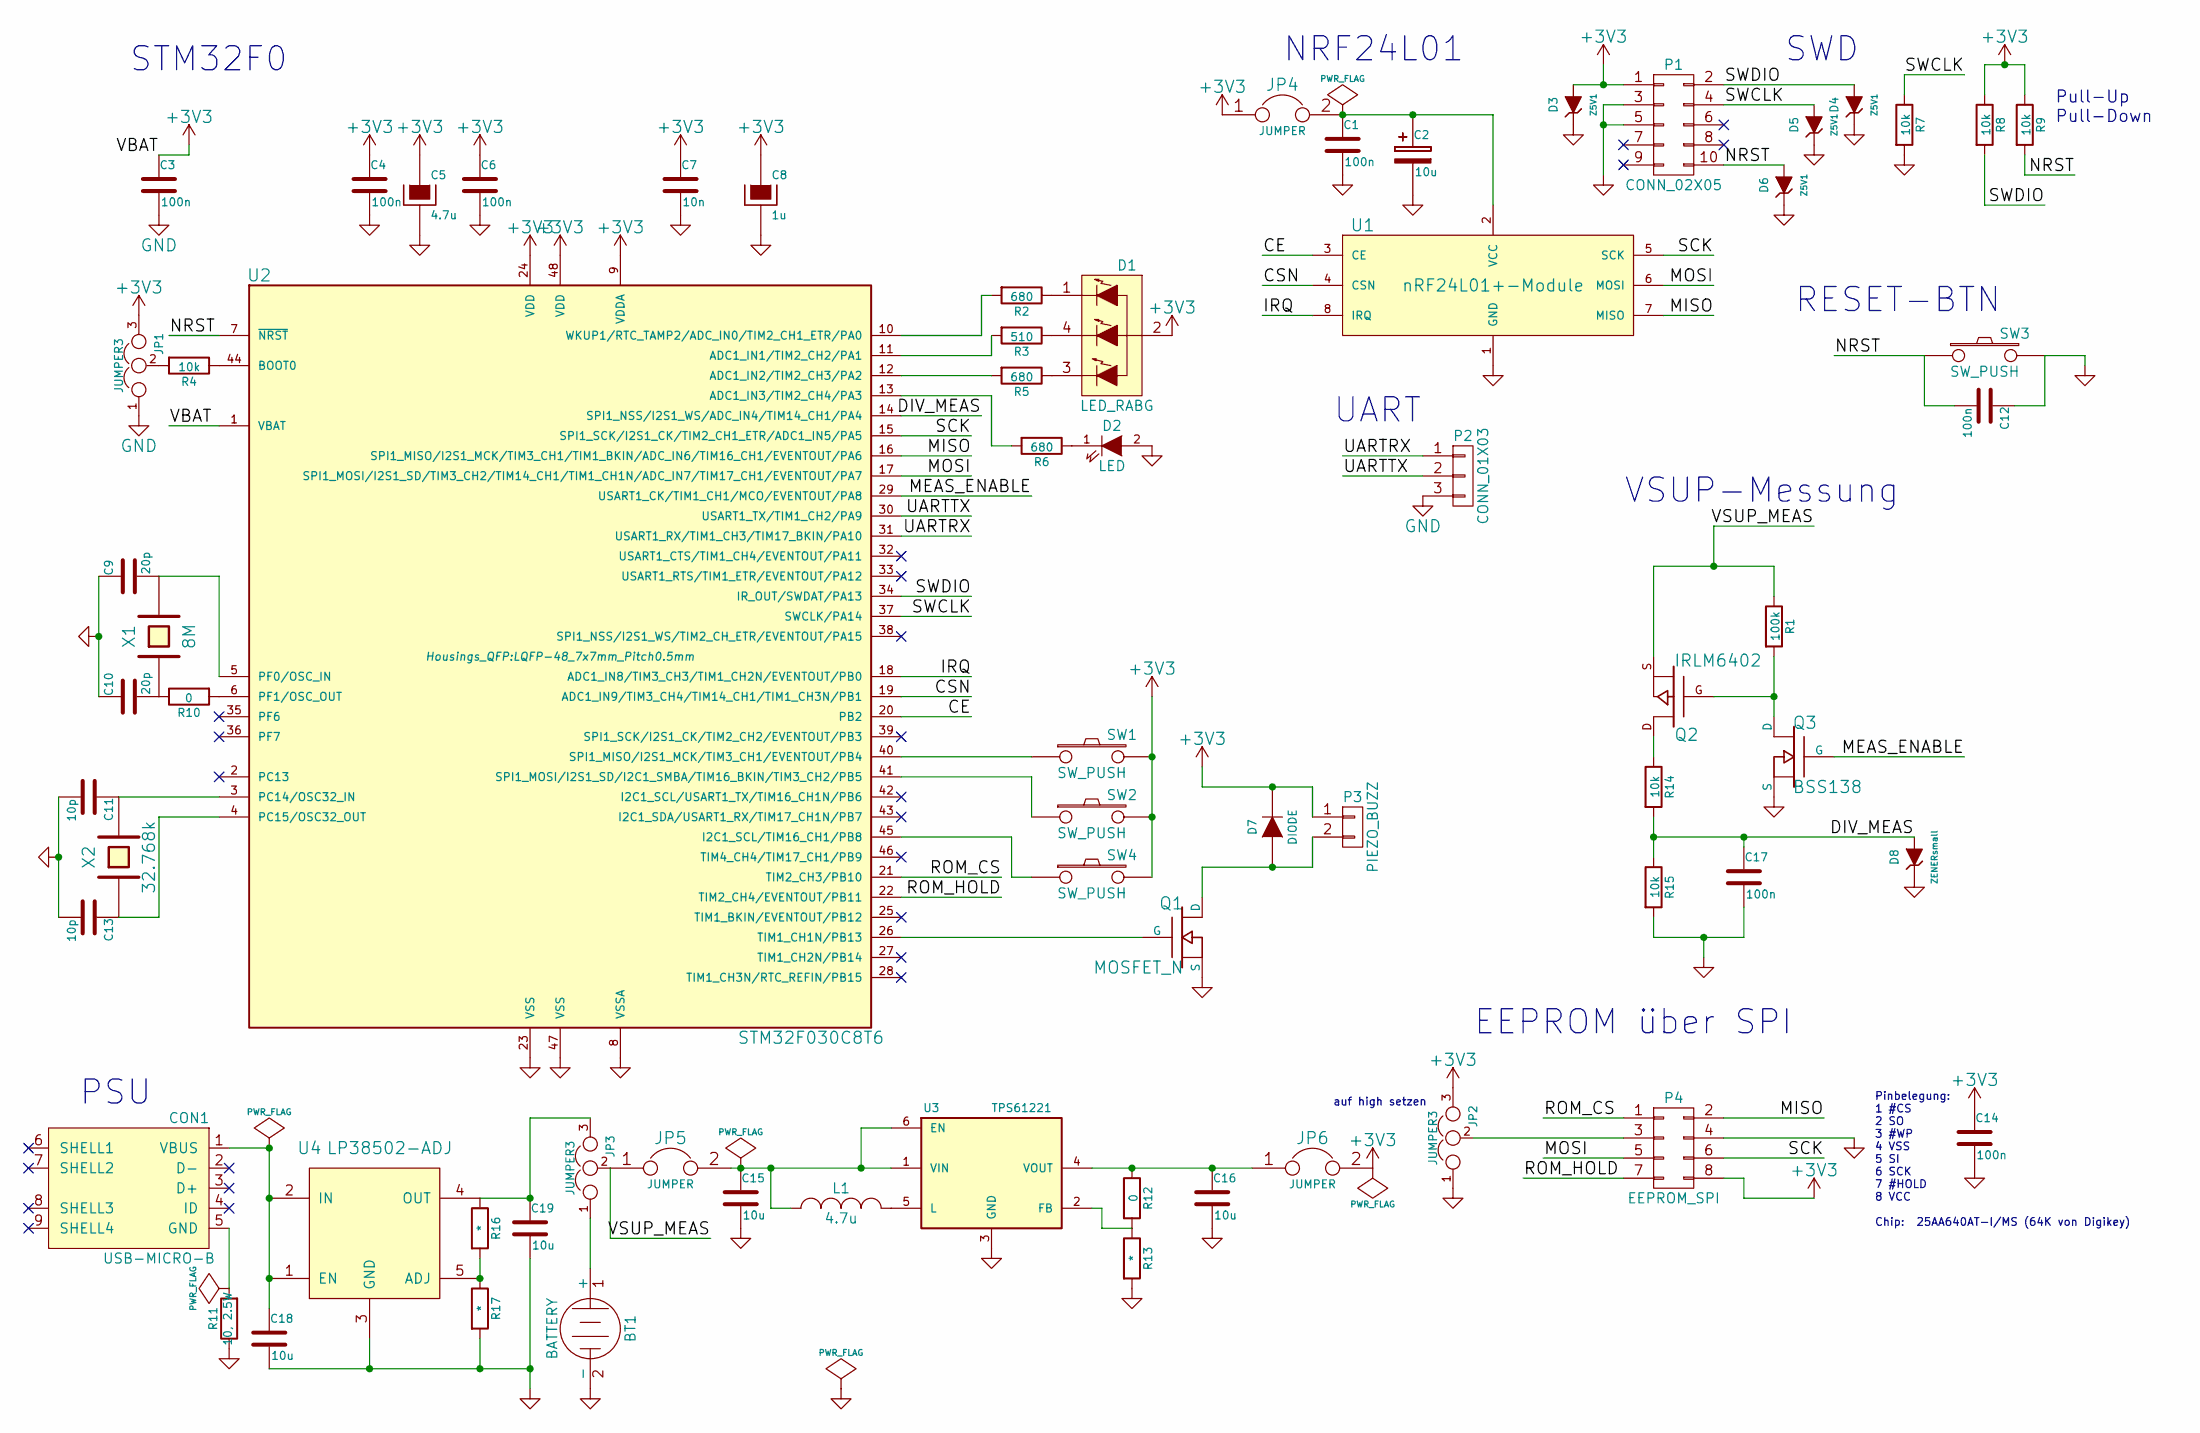
[picture p24: schematic d14b_button.sch, Cowbus Demoboard (Schaltermodul)]

Parts:
BT1: BATTERY; KZH20SMD-2
C1, C3, C4, C6, C12, C14, C17: 100n; C_0603
C2: 10u; c_elec_4x5.8
C5: 4.7u; c_elec_4x5.8
C7: 10n; C_0603
C8: 1u; C_0603
C9, C10: 20p; C_0603
C11, C13: 10p; C_0603
C15, C16, C18, C19: 10u; C_0805
CON1: USB-MICRO-B; USB_Micro-B
D1: LED_RABG; PLCC-4
D2: LED; LED-0603
D3, D4, D5, D6: Z5V1; Diode-MiniMELF_Standard
D7: DIODE; Diode-MiniMELF_Standard
D8: ZENERsmall; Diode-MiniMELF_Standard
JP1, JP2, JP3: JUMPER3; PINHEAD1-3
JP4, JP5, JP6: JUMPER; PINHEAD1-2
L1: 4.7u; NRS8030
P1: CONN_02X05; CORTEX_header_SMD
P2: CONN_01X03; PINHEAD1-3
P3: PIEZO_BUZZ; PINHEAD1-2
P4: EEPROM_SPI; MSOP-8
Q1: MOSFET_N; SOT-23-GDS
Q2: IRLM6402; SOT-23-GDS
Q3: BSS138; SOT-23-GDS
R1: 100k; R_0603
R2, R5, R6: 680; R_0603
R3: 510; R_0603
R4, R7, R8, R9, R14, R15: 10k; R_0603
R10, R12: 0; R_0603
R11: 10, 2.5W; Resistor_Horizontal_RM20mm
R13, R16, R17: *; R_0603
SW1, SW2, SW3, SW4: SW_PUSH; Button_SMD_Schurter_LSG
U1: nRF24L01+-Module; Pin_Header_Straight_2x04
U2: STM32F030C8T6; LQFP-48_7x7mm_Pitch0.5mm
U3: TPS61221; SC70-6
U4: LP38502-ADJ; TO-263-5
X1: 8M; Crystal_HC49-SD_SMD
X2: 32.768k; crystal_SMD_CPFB

Connections:
+3V3: C3.1, C4.1, C5.1, C6.1, C7.1, C8.1, C14.1, D1.2 (COMMON_ANODE), D3.2 (A), D7.2 (K), JP1.3, JP2.3, JP4.1, JP6.2, P1.1, P3.1, P4.8, R8.1, R9.1, SW1.2, SW2.2, SW4.2, U2.1 (VBAT), U2.9 (VDDA), U2.24 (VDD), U2.48 (VDD)
/CE: U1.3 (CE), U2.20 (PB2)
/CSN: U1.4 (CSN), U2.19 (ADC1_IN9/TIM3_CH4/TIM14_CH1/TIM1_CH3N/P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)
/DIV_MEAS: C17.1, D8.2 (A), R14.2, R15.1, U2.14 (SPI1_NSS/I2S1_WS/ADC_IN4/TIM14_CH1/PA4)
/IRQ: U1.8 (IRQ), U2.18 (ADC1_IN8/TIM3_CH3/TIM1_CH2N/EVENTOUT/PB0)
/MEAS_ENABLE: Q3.G, U2.29 (USART1_CK/TIM1_CH1/MCO/EVENTOUT/PA8)
/MISO: P4.2, U1.7 (MISO), U2.16 (SPI1_MISO/I2S1_MCK/TIM3_CH1/TIM1_BKIN/A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)
/MOSI: P4.5, U1.6 (MOSI), U2.17 (SPI1_MOSI/I2S1_SD/TIM3_CH2/TIM14_CH1/TI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)
/NRST: C12.2, D6.2 (A), P1.10, R9.2, SW3.1, U2.7 (~NRST)
/ROM_CS: P4.1, U2.21 (TIM2_CH3/PB10)
/ROM_HOLD: P4.7, U2.22 (TIM2_CH4/EVENTOUT/PB11)
/SCK: P4.6, U1.5 (SCK), U2.15 (SPI1_SCK/I2S1_CK/TIM2_CH1_ETR/ADC1_IN5/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)
/SWCLK: D5.2 (A), P1.4, R7.1, U2.37 (SWCLK/PA14)
/SWDIO: D4.2 (A), P1.2, R8.2, U2.34 (IR_OUT/SWDAT/PA13)
/UARTRX: P2.1, U2.31 (USART1_RX/TIM1_CH3/TIM17_BKIN/PA10)
/UARTTX: P2.2, U2.30 (USART1_TX/TIM1_CH2/PA9)
/VSUP_MEAS: JP3.2, JP5.1, Q2.S, R1.1
GND: BT1.2 (-), C1.2, C2.2, C3.2, C4.2, C5.2, C6.2, C7.2, C8.2, C9.1, C10.1, C11.2, C12.1, C13.2, C14.2, C15.2, C16.2, C17.2, C18.2, C19.2, D2.2 (A), D3.1 (K), D4.1 (K), D5.1 (K), D6.1 (K), D8.1 (K), JP1.1, JP2.1, P1.3, P1.5, P2.3, P4.4, Q1.S, Q3.S, R7.2, R11.1, R13.2, R15.2, R17.2, SW3.2, U1.1 (GND), U2.8 (VSSA), U2.23 (VSS), U2.47 (VSS), U3.3 (GND), U4.3 (GND)
unnamed: BT1.1 (+), JP3.1
unnamed: C1.1, C2.1, JP4.2, U1.2 (VCC)
unnamed: C9.2, U2.5 (PF0/OSC_IN), X1.2
unnamed: C10.2, R10.1, X1.1
unnamed: C11.1, U2.3 (PC14/OSC32_IN), X2.2
unnamed: C13.1, U2.4 (PC15/OSC32_OUT), X2.1
unnamed: C15.1, JP5.2, L1.1, U3.1 (VIN), U3.6 (EN)
unnamed: C16.1, JP6.1, R12.1, U3.4 (VOUT)
unnamed: C18.1, CON1.1 (VBUS), U4.1 (EN), U4.2 (IN)
unnamed: C19.1, JP3.3, R16.1, U4.4 (OUT)
unnamed: CON1.5 (GND), R11.2
unnamed: D1.1 (RED_CATHODE), R2.1
unnamed: D1.3 (BLUE_CATHODE), R5.1
unnamed: D1.4 (GREEN_CATHODE), R3.1
unnamed: D2.1 (K), R6.1
unnamed: D7.1 (A), P3.2, Q1.D
unnamed: JP1.2, R4.2
unnamed: JP2.2, P4.3
unnamed: L1.2, U3.5 (L)
unnamed: Q1.G, U2.26 (TIM1_CH1N/PB13)
unnamed: Q2.D, R14.1
unnamed: Q2.G, Q3.D, R1.2
unnamed: R2.2, U2.10 (WKUP1/RTC_TAMP2/ADC_IN0/TIM2_CH1_ETR/PA0)
unnamed: R3.2, U2.11 (ADC1_IN1/TIM2_CH2/PA1)
unnamed: R4.1, U2.44 (BOOT0)
unnamed: R5.2, U2.12 (ADC1_IN2/TIM2_CH3/PA2)
unnamed: R6.2, U2.13 (ADC1_IN3/TIM2_CH4/PA3)
unnamed: R10.2, U2.6 (PF1/OSC_OUT)
unnamed: R12.2, R13.1, U3.2 (FB)
unnamed: R16.2, R17.1, U4.5 (ADJ)
unnamed: SW1.1, U2.40 (SPI1_MISO/I2S1_MCK/TIM3_CH1/EVENTOUT/PB4)
unnamed: SW2.1, U2.41 (SPI1_MOSI/I2S1_SD/I2C1_SMBA/TIM16_BKIN/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)
unnamed: SW4.1, U2.45 (I2C1_SCL/TIM16_CH1/PB8)

Notes on the sheet:
STM32F0
NRF24L01
SWD
PSU
UART
RESET-BTN
EEPROM über SPI
Pinbelegung: 1 #CS 2 SO 3 #WP 4 VSS 5 SI 6 SCK 7 #HOLD 8 VCC Chip: 25AA640AT-I/MS (64K von Digikey)
auf high setzen
Pull-Up Pull-Down
VSUP-Messung

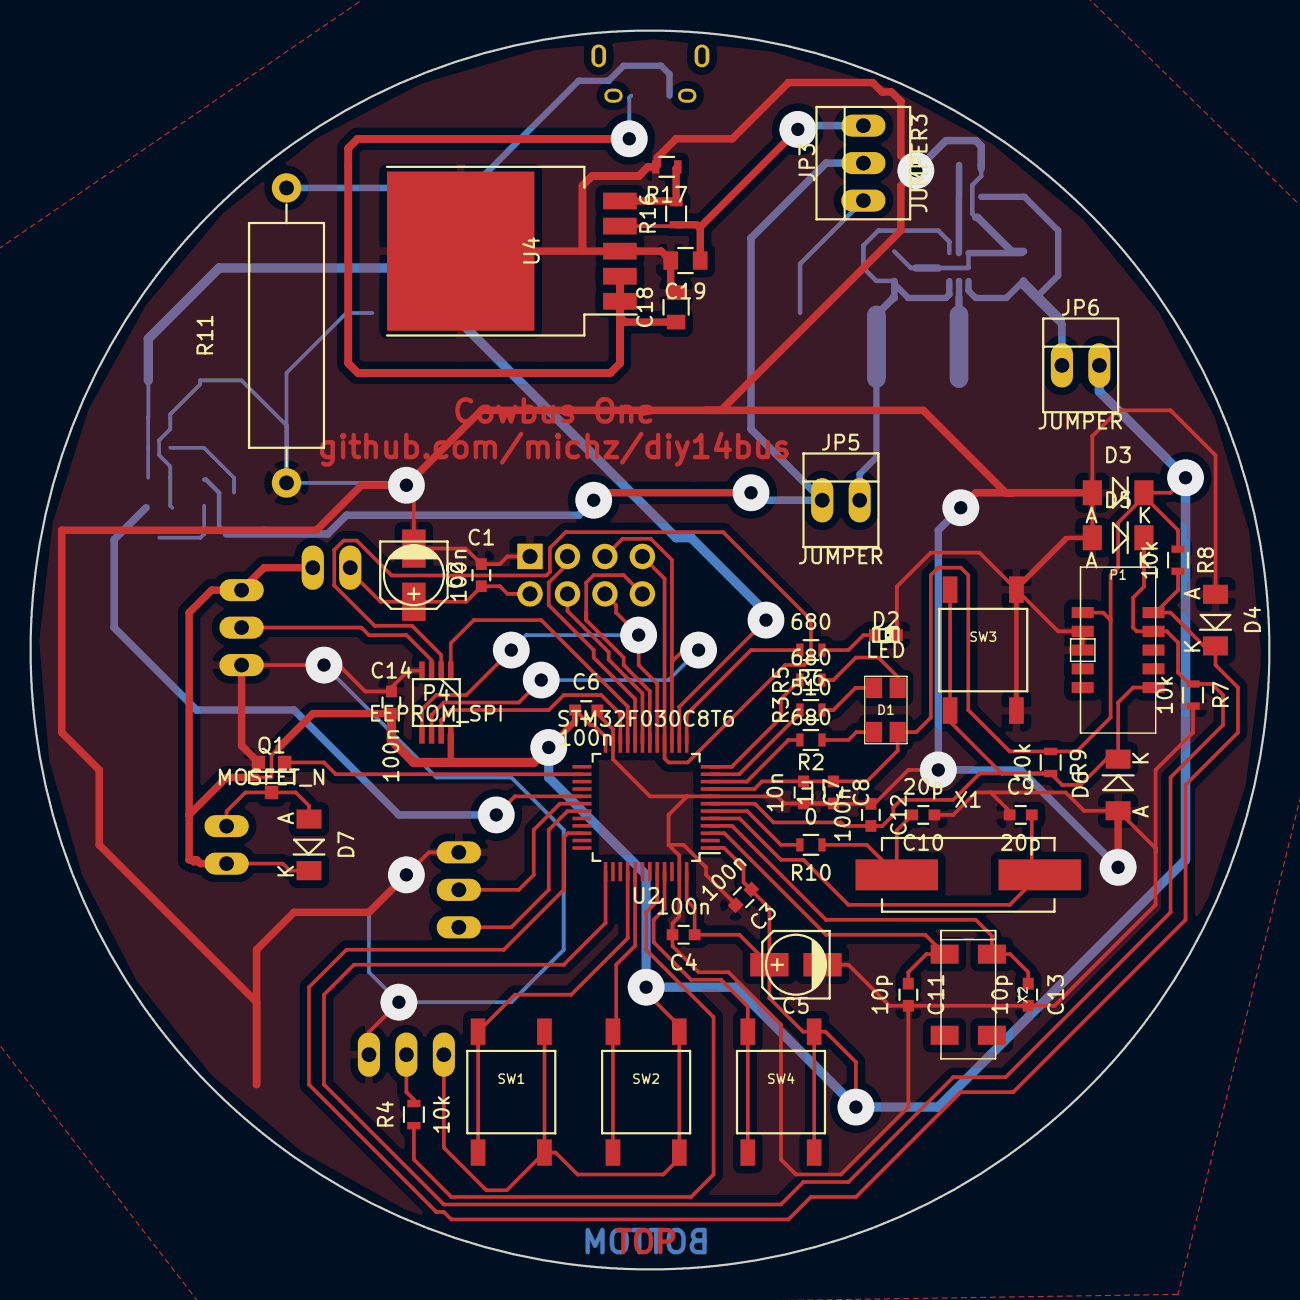
[picture p25: board d14b_button.kicad_pcb from above]

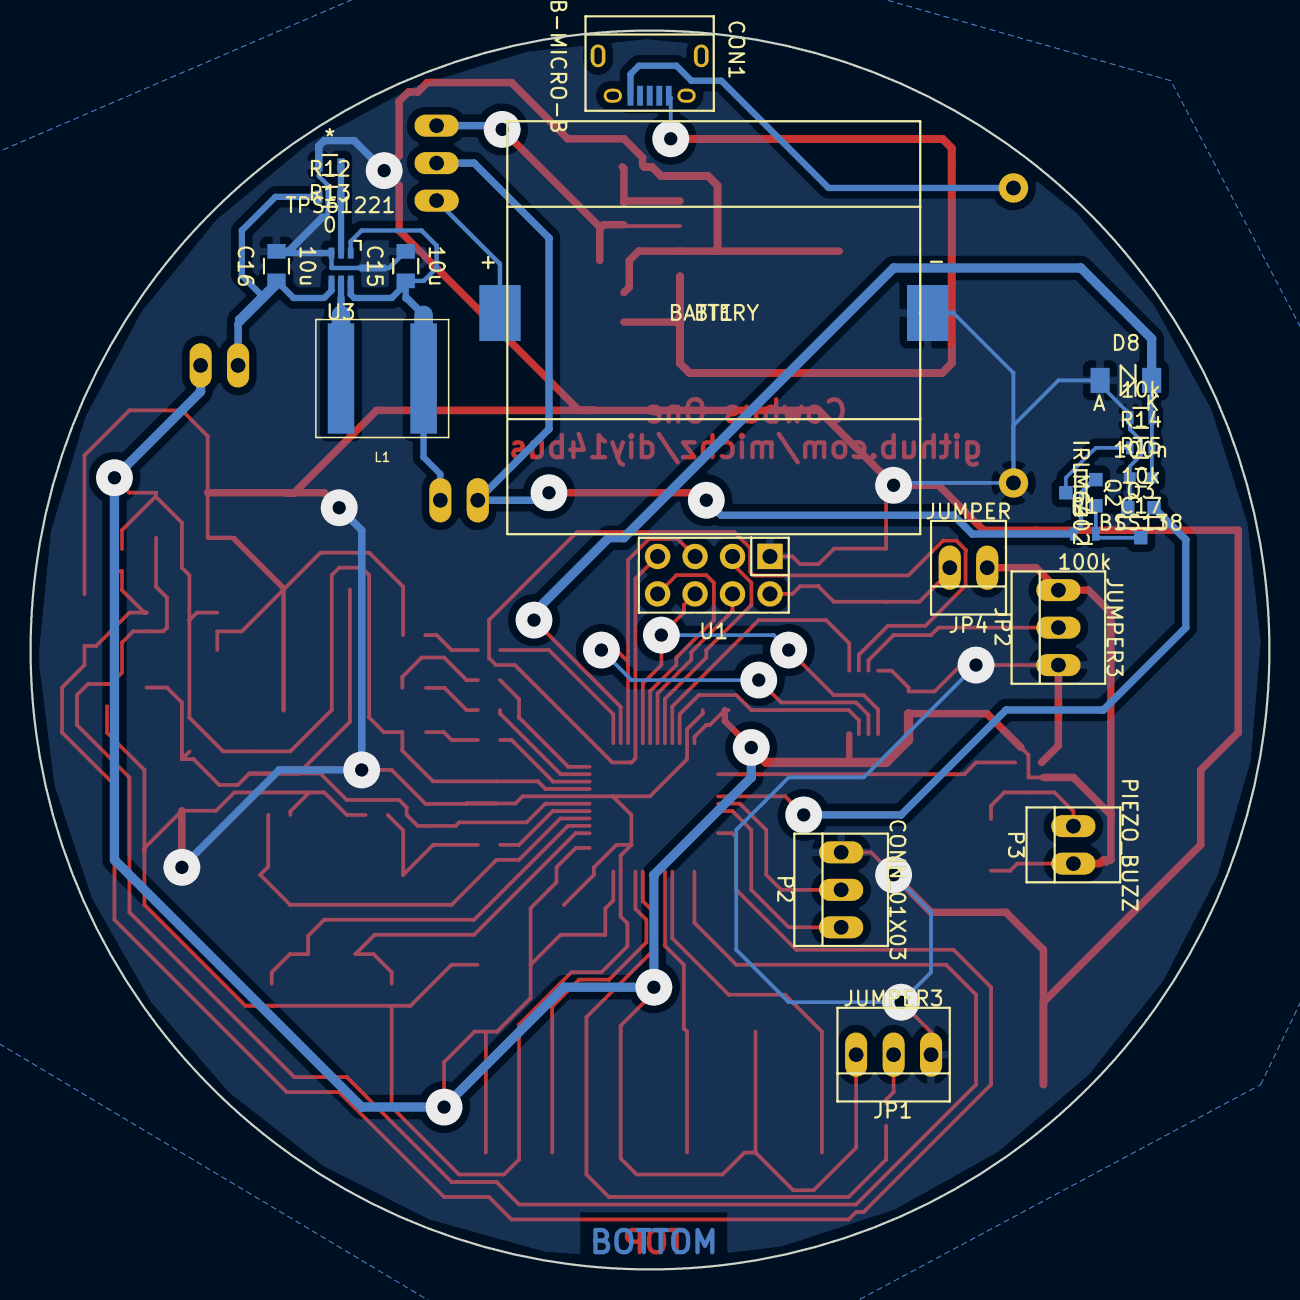
[picture p26: board d14b_button.kicad_pcb from below]

Board: 2 copper layers, 84.0 x 84.0 mm, 70 parts (21 on the bottom side), 51 nets.
