michz/diy14bus/cowbus/include/sensor.h

/**
 * @brief   TODO
 *
 * TODO
 *
 *
 *
 * @author  TODO
 * @file
 */


#ifdef NODE_IS_SENSOR

#ifndef SENSOR_H
#define SENSOR_H


/**
 * @brief   Initializes GPIOs, etc. for sensor functionality.
 */
void sensor_initialize(void);


#endif // SENSOR_H
#endif // NODE_IS_SENSOR
