michz/diy14bus/cowbus/include/actor.h

/**
 * @brief   TODO
 *
 * TODO
 *
 *
 *
 * @author  TODO
 * @file
 */


#ifdef NODE_IS_ACTOR

#ifndef ACTOR_H
#define ACTOR_H


/**
 * @brief   Initializes GPIOs, interrupts, etc. for actor functionality.
 */
void actor_initialize(void);


#endif // ACTOR_H
#endif // NODE_IS_ACTOR
