michz/diy14bus/spi-test-f0/main.c

#include "board.h" // stm32f3discovery
#include "cpu.h"
#include "periph/spi.h"
#include "periph/gpio.h"
#include "hwtimer.h"


//dies ist eine kleine Testanwendung für meine LPD8896 LED-Leiste.
// und funktioniert sogar!

//pinconfig for SPI_0
// CLK   PA5
// MISO  PA6
// MOSI  PA7


#define 	TEST_WAIT	9

int main(void)
{

	//noetig? Nein, LE nicht notwendig fuer SPI-Konfiguration.
    //GPIOA->MODER &= ~(2 << (2 * 4));           /* set pin to output mode */
    //GPIOA->MODER |= (1 << (2 * 4));
    //GPIOA->OTYPER &= ~(1 << 4);                /* set to push-pull configuration */
    //GPIOA->OSPEEDR |= (3 << (2 * 4));          /* set to high speed */
    //GPIOA->PUPDR &= ~(3 << (2 * 4));           /* configure push-pull resistors */
    //GPIOA->PUPDR |= (0b00 << (2 * 4));
    //GPIOA->ODR &= ~(1 << 4);                   /* set pin to low signal */

	LD4_ON;

	if(spi_init_master(SPI_0, SPI_CONF_FIRST_RISING, SPI_SPEED_1MHZ) != 0){
		while(1) LD3_ON; //nix mehr machen

	}
	//GPIOs work but the clock has to be enabled first:
	//RCC->AHBENR |= RCC_AHBENR_GPIOEEN;

	//GPIO_6 : PE1
	//gpio_init_out(GPIO_6, GPIO_NOPULL); //just for debug

	char blubb = 0;
	char *mirwors = &blubb; //null und NULL wollte er nicht, daher halt umstaendlich

    while(1) {
		for(uint8_t i = 0; i<30; i++){
			
			//gpio_set(GPIO_6);

			//blau
			if(spi_transfer_byte(SPI_0, 0xFF, mirwors) != 1){
				while(1) LD3_ON; //nix mehr machen
			}

			if(spi_transfer_byte(SPI_0, 0x80, mirwors) != 1){
				while(1) LD3_ON; //nix mehr machen
			}
			if(spi_transfer_byte(SPI_0, 0x80, mirwors) != 1){
				while(1) LD3_ON; //nix mehr machen
			}

			hwtimer_wait(HWTIMER_TICKS(TEST_WAIT * 1000));


			//gruen
			if(spi_transfer_byte(SPI_0, 0x80, mirwors) != 1){
				while(1) LD3_ON; //nix mehr machen
			}
			if(spi_transfer_byte(SPI_0, 0x80, mirwors) != 1){
				while(1) LD3_ON; //nix mehr machen
			}
			if(spi_transfer_byte(SPI_0, 0xFF, mirwors) != 1){
				while(1) LD3_ON; //nix mehr machen
			}

			hwtimer_wait(HWTIMER_TICKS(TEST_WAIT * 1000));
		}

		for(uint16_t i=((60+31)/32); i>0; i--) {
			if(spi_transfer_byte(SPI_0, 0x00, mirwors) != 1){
				while(1) LD3_ON; //nix mehr machen
			}
		}


		//gpio_clear(GPIO_6); //just for debug

		for(uint8_t i = 0; i<30; i++){

			//dunkel
			if(spi_transfer_byte(SPI_0, 0x80, mirwors) != 1){
				while(1) LD3_ON; //nix mehr machen
			}
			if(spi_transfer_byte(SPI_0, 0x80, mirwors) != 1){
				while(1) LD3_ON; //nix mehr machen
			}
			if(spi_transfer_byte(SPI_0, 0x80, mirwors) != 1){
				while(1) LD3_ON; //nix mehr machen
			}

			hwtimer_wait(HWTIMER_TICKS(TEST_WAIT * 1000));

			//rot
			if(spi_transfer_byte(SPI_0, 0x80, mirwors) != 1){
				while(1) LD3_ON; //nix mehr machen
			}
			if(spi_transfer_byte(SPI_0, 0xFF, mirwors) != 1){
				while(1) LD3_ON; //nix mehr machen
			}
			if(spi_transfer_byte(SPI_0, 0x80, mirwors) != 1){
				while(1) LD3_ON; //nix mehr machen
			}

			hwtimer_wait(HWTIMER_TICKS(TEST_WAIT * 1000));
		}


		for(uint16_t i=((60+31)/32); i>0; i--) {
			if(spi_transfer_byte(SPI_0, 0x00, mirwors) != 1){
				while(1) LD3_ON; //nix mehr machen
			}
		}


        //LD3_ON;
        //hwtimer_wait(HWTIMER_TICKS(TEST_WAIT * 1000));
        //LD3_OFF;
        //LD4_ON;
        //hwtimer_wait(HWTIMER_TICKS(500 * 1000));
        //LD4_OFF;
    }
    return 0;
}
