michz/diy14bus/(commit log)

2014-11-17 first LED blinking test app
2014-11-27 erstes SPI-Beispiel laeuft
2014-12-02 f0-board main c1101 Anfang
2014-12-02 koennte klappen, gibt aber compiler fehler :( ausserdem fehlt der Button noch
2014-12-04 first sensor board files created (simple switches)
    radio used: nRF24L01+
    [d14b_button.kicad_pcb, d14b_button.sch]
2014-12-05 immerhin gehen die GPIOs nun
2014-12-09 test-led eingefuegt
2014-12-09 funktionierendes spi projekt für das f0 eingefuegt
2014-12-10 added TODOs to schematic
    [d14b_button.sch]
2014-12-11 Update TPS61221
    [d14b_button.sch]
2014-12-11 TPS61221 update
    [d14b_button.sch]
2014-12-12 spi-test-f3 should work now
2014-12-17 connect output of converter to board-3v3
    [d14b_button.sch]
2015-01-09 Quartz und LED hinzugefügt.
    [d14b_button.sch]
2015-01-09 Größerer Prozessor.
    [d14b_button.sch]
2015-01-09 3V3-Label überarbeitet und BOOT0-Selektor hinzugefügt
    [d14b_button.sch]
2015-01-09 VBAT über Brücke angebunden, um evtl später Dinge ändern zu können
    [d14b_button.sch]
2015-01-09 Schaltplan um Mikrocontroller etwas aufgehübscht
    [d14b_button.sch]
2015-01-09 Schaltplan aufgeräumt
    [d14b_button.sch]
2015-01-09 UART angeschlossen
    [d14b_button.sch]
2015-01-09 SWDIO und SWCLK angeschlossen
    [d14b_button.sch]
2015-01-09 SWD: NOCONN gemäß spec
    [d14b_button.sch]
2015-01-09 dritten Schalter hinzugefügt und Annotation ausgeführt
    [d14b_button.sch]
2015-01-09 erste ERC-Runde durchgeführt
    [d14b_button.sch]
2015-01-09 SWD verkabelt
    [d14b_button.sch]
2015-01-09 Piezo Buzzer
    [d14b_button.sch]
2015-01-09 µC komplett beschalten
    [d14b_button.sch]
2015-01-09 RESET BTN
    [d14b_button.sch]
2015-01-09 PSU passt jetzt, USB fehlt noch
    [d14b_button.sch]
2015-01-09 ERC erfolgreich abgeschlossen
    [d14b_button.sch]
2015-01-09 EEPROM über SPI hinzugefügt
    [d14b_button.sch]
2015-01-09 Chip für EEPROM zu suchen
    [d14b_button.sch]
2015-01-09 einige Bauteile zugewiesen und C15 anderen Wert zugewiesen
    [d14b_button.sch]
2015-01-09 first cowbus header inserted (ideas)
2015-01-09 für Platine fehlen noch ein paar Footprints
    [d14b_button.sch]
2015-01-09 fixed missing details of previous commit
    [cowpacket.h, grazed_list.h]
2015-01-09 pdf der aktuellen Schaltplanrevision hinzugefügt, Schaltplan ordentlich beschriftet
    [d14b_button.sch]
2015-01-10 Pull-Ups für SWD-Leitungen ergänzt
    [d14b_button.sch]
2015-01-10 ERC-Fehler am USB korrigiert
    [d14b_button.sch]
2015-01-10 Fehler korrigiert: SWCLK braucht Pull-Down, nicht Pull-Up
    [d14b_button.sch]
2015-01-10 Plan wieder schön gemacht
    [d14b_button.sch]
2015-01-10 sensor.h and actor.h added, corrected Makefile
    [actor.h, main.c, sensor.h]
2015-01-11 20Pin-JTAG durch 10-Pin Cortex-Debug ersetzt
    [d14b_button.sch]
2015-01-11 Annotation korrigiert
    [d14b_button.sch]
2015-01-11 Button in lib gelegt
2015-01-12 aktuelle TODOs zur Platine ergänzt
    [d14b_button.sch]
2015-01-12 Jumper für Strommessung am Funkmodul eingefügt
    [d14b_button.sch]
2015-01-12 Strommessjumper vor dem Wandler ergänzt
    [d14b_button.sch]
2015-01-12 Label zur Messung der Batterie/’Netz’spannung ergänzt
    [d14b_button.sch]
2015-01-12 neues TODO im Schaltplan: Spannungsteiler ergänzen
    [d14b_button.sch]
2015-01-13 VBAT mit Batterie verbunden
    [d14b_button.sch]
2015-01-13 MCU wird getauscht, Vorbereitung des Symbols
2015-01-14 MCU getauscht, Schaltplan weitergebaut
    [d14b_button.sch]
2015-01-14 TODO zu Schaltplan ergänzt
    [d14b_button.sch]
2015-01-17 fixed config-server compilation, added JSON->nrf
    [cowpacket.h]
2015-01-19 TODOs im Schaltplan abgebaut, Spannungsmessung, Strommessung...
    [d14b_button.sch]
2015-01-19 alle TODOs aus Schaltplan erledigt
    [d14b_button.sch]
2015-01-20 added all footprints but the crystals
    [d14b_button.sch]
2015-01-20 alle Footprints hinzugefügt und zugeordnet
    [d14b_button.sch]
2015-01-20 Bauteile platziert
    [d14b_button.kicad_pcb, d14b_button.sch]
2015-01-20 weiterer Zwischenstand
    [d14b_button.kicad_pcb]
2015-01-20 led base, switch base, some radio code
2015-01-21 pinio und eeprom weiter
2015-01-21 switched to spi_0
2015-01-21 led1 fertig
2015-01-24 Fiebermurks verworfen, Redesign der Platine angeworfen, Interactive Routing ist geil :-)
    [d14b_button.kicad_pcb, d14b_button.sch]
2015-01-24 Fiebermurks verworfen, Redesign der Platine angeworfen --> Revision 2, Interactive Routing ist geil :-)
    [d14b_button.kicad_pcb, d14b_button.sch]
2015-01-25 Zwischenstand Platinenredesign
    [d14b_button.kicad_pcb]
2015-01-25 Platine fertig - endlich :-)
    [d14b_button.kicad_pcb]
2015-01-26 Plots für die Platinenfertigung erzeugt
    [d14b_button.kicad_pcb]
2015-01-26 Die 3V3-Zuleitung war zu dünn
    [d14b_button.kicad_pcb]
2015-01-27 ein bisschen Blafusel für die Hardwarefolie
2015-01-28 kleine Schmarrndemo für Buttons und LED
2015-02-05 corrected not compiling issue
    [main.c, radio_nrf.c]
2015-02-28 stichpunkte eingefuegt - gerne aendern und dann formulier ich sie aus
2015-02-28 doc: Brainstorming und Projektplanung
2015-02-28 dies und das
2015-02-28 und zum fehlenden Komma noch die überflüssigen Datumsangaben entfernt...
2015-03-01 der pi
2015-03-01 Typo und sinnvolle Pakete für die Preambel, fixes kaputte Trennung
2015-03-01 kaputten Bindestrich gefixt Beispiel-Sensor
2015-03-01 Komma und Typo
2015-03-01 Kommata und Anführungszeichen
2015-03-01 package microtype hinzugefügt, macht manche Mikrotypographie gefälliger und erlaubt nachher mit einem Frickelfaktor den Text auf 6 Seiten zu optimieren
2015-03-01 Prozessor- und Herstellernamen ge-emph-t
2015-03-01 wir versuchen nicht -> ausgebessert :)
2015-03-17 interrupt test der nicht geht eingefuegt
2015-03-20 pindifferenz added
    [pindifferenz.ods]
2015-03-24 eeprom und uart angefangen
2015-03-27 update schematic to new symbols and generate PDF
    [d14b_button.sch]
2015-03-27 uart geht nicht :(
2015-03-27 fix wrong EEPROM-connection in schematic
    [d14b_button.sch]
2015-03-27 fix for mirrored right side of EEPROM
    [d14b_button.kicad_pcb]
2015-05-10 idea for prototyping board added
    [d14b_button_2.kicad_pcb, d14b_button_2.sch, pindifferenz.ods]
2015-05-15 Spannungswandler für USB hinzugefügt
    [d14b_button.kicad_pcb, d14b_button.sch]
2015-07-15 first steps for prototypong board
    [cowbus-protoboard.sch, power_supply.sch, radio.sch]
2015-07-15 mad emcu second hierarchy, added top level, added empty periph
    [cowbus-protoboard.sch, main_power_supply.sch, mcu.sch, periph.sch, power_supply.sch, radio.sch]
2015-07-15 Buzzer added, RGB added, further GPIO added
    [cowbus-protoboard.sch, main_power_supply.sch, mcu.sch, periph.sch, radio.sch]
2015-07-15 values added, 100n for uC added
    [cowbus-protoboard.sch, main_power_supply.sch, mcu.sch, periph.sch, power_supply.sch, radio.sch]
2015-07-16 added temp sensor, added usart for printf-debugging
    [cowbus-protoboard.sch, main_power_supply.sch, mcu.sch, periph.sch, power_supply.sch, radio.sch]
2015-07-16 some footprint assignments done
    [cowbus-protoboard.sch, main_power_supply.sch, mcu.sch, periph.sch, power_supply.sch, radio.sch]
2015-07-31 first version of layout for protoboard
    [cowbus-protoboard.kicad_pcb, cowbus-protoboard.sch, main_power_supply.sch, mcu.sch, periph.sch, power_supply.sch, radio.sch]
2015-08-01 added GPIO18, better 3V3, better GND
    [cowbus-protoboard.kicad_pcb, cowbus-protoboard.sch, main_power_supply.sch, mcu.sch, periph.sch, power_supply.sch, radio.sch]
2015-08-01 wrong LDO pinout corrected + README
    [cowbus-protoboard.kicad_pcb, cowbus-protoboard.sch, main_power_supply.sch, mcu.sch, periph.sch, power_supply.sch, radio.sch]
2015-08-02 added schematics rev, annotation fixed, OSHW logo
    [cowbus-protoboard.kicad_pcb, cowbus-protoboard.sch, main_power_supply.sch, mcu.sch, periph.sch, power_supply.sch, radio.sch]
2015-08-10 PDF and Gerber files for revision 1 added
    [cowbus-protoboard.kicad_pcb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]
2015-08-11 switch.c added interrupt initialisation
2015-08-13 protoboard: added mask gerber and pdf
    [cowbus-protoboard.kicad_pcb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]
2015-08-14 basic checksum; severe bug in c++-nrf- usage; cross-compilation for PI
    + better shutdown in config-server for quickly reuse of ports
    [cowpacket.h, main.c]
2015-08-15 protoboard: added debug_uart pin markers
    [cowbus-protoboard.kicad_pcb]
2015-08-15 protoboard: added V_in markers (GND, voltage)
    + updated gerber and PDF files
    [cowbus-protoboard.kicad_pcb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]
